JUYU-fsw/IT-preparation/PCB接线与引脚速查.md

# MSPM0G3507 终版小车 PCB 接线与引脚速查

> 用途：供人和 AI 快速查询板载接口、MCU 引脚及电气限制。后续开发优先查本文件，不从 Gerber 猜网络。  
> 原理图版本：`2026-06-13`，板名“2026电赛天猛星最终版”，V1.0。  
> 最后核对：2026-07-24。

## 1. 信息来源与使用规则

- **网络连接唯一依据**：`D:\ai embody\TI preparation\PCB\TI板卡\原理图文件\SCH_Schematic1_2026-06-13.pdf`
- **PCB 成品资料**：`D:\ai embody\TI preparation\PCB\TI板卡\Gerber2\10.zip`
- **工程引脚限制**：各工程下的 `project\尽量不要使用的引脚.txt`
- **实机修正优先级**：实机测量/已验证结果 > 2026-06-13 原理图 > 本文 > Gerber 丝印推断。
- 插头方向必须以 PCB 方形焊盘、数字 `1` 或连接器缺口确认；不要仅凭“从左到右”判断。
- 若本文与实物不一致，先停止上电并记录接口名、丝印、线序和测量结果，再更新本文。

## 2. 电源与共地

| 网络 | 用途 | 关键说明 |
|---|---|---|
| `12V_POWER` | 外部 12 V 输入开关前网络 | 经 U21 开关后成为 `12V` |
| `12V` | TB6612 VM、电机电源、UART3/UART5 电机兼容口 | 禁止接普通 5 V 串口模块 |
| `+5V` | TB6612 逻辑、编码器、OLED/IMU/部分接口供电 | USB-TTL 5 V 不得与已供电载板并联 |
| `VCC/3V3` | MSPM0 逻辑电源 | MCU GPIO 是否 5 V 容忍必须按器件资料确认 |
| `GND` | 全板公共地 | 外部电源、烧录器、USB-TTL 通信时必须共地 |

### 电源接口

| 接口 | 引脚/网络 | 用途 |
|---|---|---|
| U43（XT60） | 1=`12V_POWER`，2=`GND` | 主电源输入 |
| U21 | `12V_POWER` → 开关 → `12V` | 主电源开关 |
| U19 | IN+=`12V`，IN-=`GND`，OUT+=`+5V`，OUT-=`GND` | 12 V 转 5 V 模块 |
| CN14 | 1=`12V`，2=`GND` | 12 V 引出 |
| CN13 | 1=`+5V`，2=`GND` | 5 V 引出 |

### 上电安全

- 3S/12 V/5 V 链路和实车电机运行已验证，正式工程使用 `TB6612_OUTPUT_ENABLE=1`；上电默认 PWM=0，蓝牙 `1` 完成 3 秒等待后才运行。
- 外部电源给 PCB 和电机供电时，烧录器只接 GND、SWDIO、SWCLK、NRST、VTref；关闭或断开烧录器 target power。
- USB-TTL 单向日志只需 `GND` 和“板端 TX → USB-TTL RX”，不要接 USB-TTL 的 5 V。
- 电机额定电流 1 A、堵转电流 2 A；当前已启用 TB6612 并完成实车巡线，后续高负载运行仍需观察电流和散热余量。

## 3. 当前正式功能引脚总表

| 模块/信号 | MCU 引脚 | 外设/功能 | 当前状态 |
|---|---|---|---|
| 调试 UART TX | PB6 | UART1 TX | 已验证，115200 |
| 调试 UART RX | PB7 | UART1 RX | 已验证，通常不接 TTL TX |
| 蜂鸣器 | PA7 | GPIO | 低电平触发 |
| OLED SCL | PA31 | 软件 I2C | 已验证 |
| OLED SDA | PA28 | 软件 I2C | 已验证 |
| IMU SCL | PA1 | 软件 I2C | 线路曾验证；旧模块已损坏，待新模块复测 |
| IMU SDA | PA0 | 软件 I2C | 线路曾验证；旧模块已损坏，待新模块复测 |
| IMU INT | PB4 | GPIO/中断 | 原理图已接，当前非必需 |
| 状态 LED | PB16 | GPIO | 当前程序心跳 |
| 核心板 LED | PA14 | GPIO | 与 MOTOR1 编码器 B 共用，不作为正式心跳 |
| 电机 PWM A | PA12 | TIMG0_C0 | TB6612 PWMA |
| 电机方向 AIN1 | PB17 | GPIO | MOTOR2 驱动方向 |
| 电机方向 AIN2 | PB19 | GPIO | MOTOR2 驱动方向 |
| 电机 PWM B | PA13 | TIMG0_C1 | TB6612 PWMB |
| 电机方向 BIN1 | PA16 | GPIO | MOTOR1 驱动方向 |
| 电机方向 BIN2 | PB24 | GPIO | MOTOR1 驱动方向 |
| MOTOR1 编码器 A | PA25 | GPIO 双边沿中断 | 已纠正并验证 |
| MOTOR1 编码器 B | PA14 | GPIO 双边沿中断 | 已纠正并验证 |
| MOTOR2 编码器 A | PA26 | GPIO 双边沿中断 | 已验证 |
| MOTOR2 编码器 B | PA27 | GPIO 双边沿中断 | 已验证 |
| 灰度地址 A0 | PB25 | GPIO 输出 | 已验证 |
| 灰度地址 A1 | PB18 | GPIO 输出 | 已验证 |
| 灰度地址 A2 | PB21 | GPIO 输出 | 已验证 |
| 灰度 OUT | PB22 | GPIO 输入 | 必须接入；2026-07-27 曾漏接并导致持续 M00，补接后巡线正常 |

## 4. 串口接口

### 普通 5 V 四针串口

| 板载接口 | 1 脚 | 2 脚 | 3 脚 | 4 脚 | MCU 外设 |
|---|---|---|---|---|---|
| UART0 | +5V | GND | RX=PA1 | TX=PA0 | UART0 |
| UART1 | +5V | GND | RX=PB7 | TX=PB6 | UART1 |
| UART2 | +5V | GND | RX=PA24 | TX=PA23 | UART2 |

- 当前正式调试口使用 **UART1**，因为 PA0/PA1 已用于 IMU。
- UART0/1/2 的发送功能均已实机验证；USB-TTL 使用交叉接法：板 TX 接 TTL RX。

### 电机兼容/特殊串口

| 板载接口 | 1 脚 | 2 脚 | 3 脚 | 4 脚 | 说明 |
|---|---|---|---|---|---|
| UART3 | TX=PA23 | RX=PA24 | GND | 12V | 与 UART2 共用信号，含 12 V |
| UART4（Zigbee） | +5V | RX=PB3 | TX=PB2 | GND | 实际对应 MCU UART3 |
| UART5 | TX=PB6 | RX=PB7 | GND | 12V | 与 UART1 共用信号，含 12 V |

> **高风险**：UART3/UART5 的 4 脚是 12 V，不是 5 V。普通 USB-TTL 不得插到这两个接口的电源脚。

## 5. TB6612 与双电机接口

### TB6612 模块排针

| TB6612 信号 | PCB 网络/MCU | 说明 |
|---|---|---|
| VM | 12V | 电机功率电源 |
| VCC | +5V | 逻辑电源 |
| GND | GND | 两侧均有地 |
| PWMA | PA12 / TIMG0_C0 | MOTOR2 PWM |
| AIN1 | PB17 | MOTOR2 方向 |
| AIN2 | PB19 | MOTOR2 方向 |
| AO1/AO2 | MOTOR2 M4/M3 | MOTOR2 电机两端 |
| STBY | +5V | 硬件常使能 |
| PWMB | PA13 / TIMG0_C1 | MOTOR1 PWM |
| BIN1 | PA16 | MOTOR1 方向 |
| BIN2 | PB24 | MOTOR1 方向 |
| BO1/BO2 | MOTOR1 M1/M2 | MOTOR1 电机两端 |

### 六针电机接口线序

以下为原理图符号**自上而下**的网络顺序；实际插线前仍须以 PCB 的 1 脚标识确认物理方向。

| 接口 | 自上而下网络顺序 | 编码器引脚 |
|---|---|---|
| MOTOR1 | `M2/BO2`、`+5V`、`A/PA25`、`B/PA14`、`GND`、`M1/BO1` | A=PA25，B=PA14 |
| MOTOR2 | `M4/AO1`、`+5V`、`A/PA26`、`B/PA27`、`GND`、`M3/AO2` | A=PA26，B=PA27 |

### 电机与编码器参数

- 减速比：56:1；额定转速：178 RPM。
- 额定电流：1 A；堵转电流：2 A。
- 额定转矩：6.5 N·m；最大转矩：9 N·m。
- 编码器推荐 5 V 供电，本体为 AB 两相；每电机轴 11 个 AB 周期。
- MCU 软件四倍频后理论输出轴计数：`11×56×4=2464 count/rev`。
- 两轴十圈实测平均：`2473.5 count/rev`；正式速度闭环按用户决定采用商家 `2450 count/rev`。
- 5 V 编码器的 AB 输出电平兼容性尚需确认：检查是否有板载调理、开漏上拉或 3.3 V 兼容输出。

## 6. 蜂鸣器、OLED 与 IMU

### 蜂鸣器 U3

| 引脚 | 网络 | 说明 |
|---|---|---|
| 1 | VCC/3.3V | 模块逻辑侧供电 |
| 2 | PA7 | 低电平触发 |
| 3 | GND | 地 |

### OLED

| 顺序 | 网络 | 说明 |
|---|---|---|
| 1 | GND | 地 |
| 2 | VCC | 电源 |
| 3 | SCL=PA31 | 软件 I2C |
| 4 | SDA=PA28 | 软件 I2C |

- 已验证为 SSD1306、128×64、I2C 地址 0x3C。

### IMU（U41，板上标注 MPU6050）

| 引脚 | 网络 | 当前用途 |
|---|---|---|
| 1 VCC | +5V | 模块供电 |
| 2 GND | GND | 地 |
| 3 SCL | PA1 | 软件 I2C SCL |
| 4 SDA | PA0 | 软件 I2C SDA |
| 5 XDA | NC | 未使用 |
| 6 XCL | NC | 未使用 |
| 7 AD0 | GND | I2C 地址选择为 0x68 |
| 8 INT | PB4 | 中断输出，当前非必需 |

- 实装芯片识别为 MPU-6500 或兼容器件：I2C 地址 0x68，`WHO_AM_I=0x70`。
- 上电水平静止约 4 秒，以 125 Hz 采集 500 点完成零偏校准。
- 上述识别与校准是旧模块损坏前的历史结果；该模块现已移除。替换 GY-521 后需重新验证 `WHO_AM_I`、温升、零偏和安装方向。

## 7. 舵机接口

四个 XH-3A 接口均为三针：1=信号、2=+5V、3=GND。

| 接口 | 1 脚信号 | 定时器通道 |
|---|---|---|
| U35 | PA22 | TIMA0_C1 |
| U39 | PA15 | TIMA0_C2 |
| U36 | PA17 | TIMA0_C3 |
| U34 | PA21 | TIMA0_C0 |

> PA21、PA23 属于核心板建议避免使用的特殊引脚；使用 PA21 舵机口前应核对核心板器件限制。

## 8. RGB 与扩展接口

### RGB 三针接口

| 接口 | 信号 | 电源 | 地 |
|---|---|---|---|
| U1 | PA14 | VCC | GND |
| U2 | PA18 | VCC | GND |
| U5 | PA2 | VCC | GND |

- PA14 同时连接核心板 LED，并在当前工程中作为 MOTOR1 编码器 B，不应再接 RGB 负载。

### 其余 IO

- H55：1=PB25，2=PB18，3=PB21，4=PB22，5=PA30，6=PB0，7=PB1，8=PB10，9=PB11，10=PB14。
- H56：10=PB5，9=PB15，8=PA10，7=PB16，6=PB13，5=PA11，4=PB12，3=PB26，2=PB27；1 脚在原理图中未标出有效网络，使用前须实测确认。
- H51/H52/H53/H54/H60/H61 为辅助排针/引出位；原理图未给出统一功能名，未确认前不要按位置猜用途。

## 9. 核心板 80 Pin 对照

| Pin | 网络 | Pin | 网络 | Pin | 网络 | Pin | 网络 |
|---:|---|---:|---|---:|---|---:|---|
| 1 | GND | 2 | GND | 41 | GND | 42 | +5V |
| 3 | PA0 | 4 | PA28 | 43 | GND | 44 | 3V3 |
| 5 | PA1 | 6 | PA31 | 45 | RST | 46 | PA18 |
| 7 | PA8 | 8 | PB4 | 47 | PB11 | 48 | PB14 |
| 9 | PA9 | 10 | PB5 | 49 | PB10 | 50 | PA7 |
| 11 | PB15 | 12 | PA10 | 51 | PB0 | 52 | PB1 |
| 13 | PB16 | 14 | PA11 | 53 | PA30 | 54 | GND |
| 15 | PB2 | 16 | PB12 | 55 | PB21 | 56 | PB22 |
| 17 | PB3 | 18 | PB13 | 57 | GND | 58 | +5V |
| 19 | DIO | 20 | CLK | 59 | GND | 60 | 3V3 |
| 21 | GND | 22 | 3V3 | 61 | PA2 | 62 | PA23 |
| 23 | GND | 24 | +5V | 63 | PB19 | 64 | PA21 |
| 25 | PB6 | 26 | PB7 | 65 | PB17 | 66 | PB18 |
| 27 | PB8 | 28 | PB9 | 67 | PA16 | 68 | PA17 |
| 29 | PA12 | 30 | PA13 | 69 | PA14 | 70 | PA15 |
| 31 | PB23 | 32 | PB26 | 71 | PB20 | 72 | PA22 |
| 33 | PB27 | 34 | PA29 | 73 | PB25 | 74 | PB24 |
| 35 | AGND | 36 | CHIP | 75 | PA25 | 76 | PA24 |
| 37 | GND | 38 | 3V3 | 77 | PA27 | 78 | PA26 |
| 39 | GND | 40 | +5V | 79 | GND | 80 | GND |

## 10. 核心板建议避免使用的引脚

- 建议避免：PA23、PA21、PA19、PA20、PA5、PA6、PA4、PA3。
- PA14 连接核心板 LED；当前又作为 MOTOR1 编码器 B，禁止再分配其他功能。
- 若必须使用 PA23/PA21，核心板说明要求移除 R8、R9、C14、C15 后才可正常使用；实际操作前必须再次核对核心板原理图。
- 载板虽然已将 PA23 引到 UART2/UART3、PA21 引到舵机 U34，但“已布线”不等于“可无条件使用”。

## 11. 已确认的易错点

- 旧记录曾把 MOTOR1 编码器写成 PA24/PA25；**正确值是 PA25/PA14**。
- 板载 `UART4` 是接口编号，实际对应 MCU UART3（PB2/PB3）。
- UART3 与 UART2 共用 PA23/PA24，但 UART3 接口带 12 V。
- UART5 与 UART1 共用 PB6/PB7，但 UART5 接口带 12 V。
- UART0 PA0/PA1 当前已被 IMU 软件 I2C 使用，正式调试串口必须用 UART1。
- 旧 IMU 已出现 `WHO_AM_I=FF`、三轴全零并明显发烫，当前已移除且禁止再次上电；LED 亮不代表芯片正常。
- 替换件选标准 GY-521 MPU6050，必须逐针确认顺序为 `VCC/GND/SCL/SDA/XDA/XCL/AD0/INT`，并确认排母插入方向使 VCC 对 VCC。相同针序反向插入仍会烧毁。
- 新模块首次只接控制板，先核对实际供电、电流、温升和 I2C 响应；确认正常后再接电机。新 GY-521 通常为 `WHO_AM_I=0x68`，软件需兼容旧模块的 0x70 和新模块的 0x68。
- MOTOR1/MOTOR2 与整车左右轮、正 PWM 与前进方向的关系仍须装车实测，不能仅凭接口编号推断。

## 12. AI 修改代码前检查清单

1. 先查“当前正式功能引脚总表”，确认没有重复占用。
2. 涉及电源时明确写出 3.3 V、5 V 或 12 V，不使用含糊的 `VCC` 代替。
3. 涉及 UART3/UART5 时先提示其接口含 12 V。
4. 涉及电机时确认主电源、左右轮映射、PWM 方向、编码器符号及 `TB6612_OUTPUT_ENABLE=1`。
5. 涉及编码器时固定使用 MOTOR1=PA25/PA14、MOTOR2=PA26/PA27。
6. 涉及 IMU 时保留 PA0/PA1，不把调试 UART 改回 UART0。
7. 新发现的实机线序或原理图差异必须同时更新本文件和《调试日志.md》。
