JUYU-fsw/IT-preparation/开发进度.md

# MSPM0G3507 终版小车开发进度

> 更新日期：2026-07-26
> 本文件只记录当前有效状态、已完成里程碑和真正未完成事项；历史排错过程见《调试日志.md》。

## 项目位置

- 工作区：`D:\ai embody\TI preparation`
- 正式工程：`D:\ai embody\TI preparation\project\MSPM0G3507_Car`
- Keil 工程：`project\MSPM0G3507_Car\project\mdk\SeekFree_MSPM0G3507_Device_Library.uvprojx`
- 主程序：`project\MSPM0G3507_Car\project\user\src\main.c`
- `before the final car` 仅为学长车 PID 历史测试副本，不是当前开发基线。

## 当前项目状态

此小车准备用于参加电赛，因此在分析时可结合往年考题。终版双轮小车的实车固件已经完成主控工具链、烧录、板载外设、双电机驱动、双编码器、速度闭环、HC-05 双向通信、YB-MVX05 八路灰度接入以及自适应巡线。用户已完成实车验证并确认巡线效果完美。

## 项目开发路径

**烧录与 LED ✅ → UART 调试 ✅ → 蜂鸣器 ✅ → OLED ✅ → IMU 识别与校准 ✅ → TB6612 与供电 ✅ → 双编码器解码与标定 ✅ → 自有电机速度闭环 ✅ → HC-05 双向启停 ✅ → 八路灰度接入 ✅ → 自适应巡线 ✅ → 弯道/急弯/丢线处理 ✅ → 按赛题扩展与逐步提速 ← 当前**

- 实车不是“等待接入灰度”或“等待基础循迹”阶段；这两项已经完成。
- 当前主线是保持已验收巡线基线，按赛题增加功能；若需要提速，每次只把直线速度提高 5 RPM 并复测全赛道。

## 当前硬件映射

| 功能 | 当前有效映射 |
|---|---|
| 左轮 | MOTOR1 编码器 PA25/PA14 + TB6612 B |
| 右轮 | MOTOR2 编码器 PA26/PA27 + TB6612 A |
| 电机 PWM/方向 | A：PA12/PB19/PB17；B：PA13/PA16/PB24 |
| 调试串口 | UART1，PB6/PB7，115200 |
| HC-05 | 板载 UART4（MCU UART3），PB2/PB3，9600 |
| OLED | SSD1306，PA31/PA28 软件 I2C，地址 0x3C |
| 蜂鸣器 | PA7，低电平触发 |
| 灰度地址 A0/A1/A2 | PB25/PB18/PB21 |
| 灰度数字输出 OUT | PB22 |

灰度模块使用 H55-1～H55-4，黑线有效为高电平；软件约定 bit0 为最左侧、bit7 为最右侧。传感器阵列位于驱动轮轴线前约 7～8 cm，该安装距离已通过实车验证。

## 已验收实车固件参数

| 类别 | 当前参数 |
|---|---|
| 电机 | 56:1，178 RPM，额定电流 1 A、堵转电流 2 A |
| 编码器换算 | `2450 count/rev` |
| 基础循环 | 10 ms |
| 测速/速度 PI 周期 | 20 ms |
| 双轮速度 PI | KP=10、KI=1.0、KD=0 |
| 速度滤波 | `alpha=0.25` |
| 输出限幅 | 8000 |
| 起步补偿 | 1000 |
| 直线巡线速度 | 55 RPM |
| 普通弯最低速度 | 20 RPM |
| 急弯 | 外轮 28 RPM、内轮 -12 RPM |
| 丢线搜索 | 外轮 22 RPM、内轮 -10 RPM，最多 200 ms |

## 已验收实车巡线行为

1. 上电保持停车；HC-05 发送 `1` 后等待 3 秒并持续巡线，发送 `0` 立即停车。
2. 八路灰度以 `-350～350` 权重计算位置误差。
3. 普通弯按误差和误差变化率立即降低基础速度；回正后逐渐恢复速度。
4. 外轮不会因转向修正而超过当前基础速度；内轮可减速、停止或反转。
5. 最外侧连续命中 20 ms 后进入急弯状态，中心通道稳定 30 ms 后退出。
6. 丢线后沿最后一次误差方向搜索 200 ms，仍未找到才停车。
7. 串口日志输出 `mode/mask/error/base/correction/target/rpm`。

## 已完成里程碑

- **2026-07-23**：Keil/Arm Compiler 6、CMSIS-DAP、LED、UART、蜂鸣器和 OLED 实机通过。
- **2026-07-23**：MPU-6500 兼容芯片识别与零偏校准完成。
- **2026-07-23**：TB6612 底层和双编码器四倍频解码完成；MOTOR1 引脚纠正为 PA25/PA14。
- **2026-07-23**：自有电机十圈标定平均约 2473.5 count/rev；正式闭环按用户决定采用商家 2450 count/rev。
- **2026-07-25**：左右轮、驱动通道和编码器反馈符号完成实车校正。
- **2026-07-25**：30 RPM 闭环误差约 1%；20/30/60/100 RPM 架空测试均稳定，最高 duty 不到 6000。
- **2026-07-25**：HC-05 PB2/PB3 双向通信及 `1/0` 启停实机通过。
- **2026-07-26**：YB-MVX05 接入终版载板，完成八路扫描、加权位置误差和巡线外环。
- **2026-07-26**：完成动态弯道降速、外轮限速、急弯状态机和丢线恢复；用户实车确认巡线完美。
- **2026-07-26**：巡线直线速度继续提高到 70 RPM，用户确认实车稳定；70 RPM 作为当前速度基线。
- **2026-07-26**：`Car_angle` 已加入 MPU6050/MPU6500 兼容角度累计、角度 PID 和编码器里程计；倾斜安装通过三轴陀螺仪向车体竖直轴投影修正。
- **2026-07-26**：安装状态下采用实测比例系数 1.268 后，手动旋转 90° 显示 89.7°，达到当前 ±3°测角目标；一圈手动测试显示 372.2°，后续需用可靠角度基准复标。
- **2026-07-26**：修复角度调试时 HC-05 乱码/不稳定：日志缓冲区由 128 扩至 256 字节，详细 IMU 遥测只发 UART1，蓝牙仅保留命令和短应答。
- **2026-07-26**：停车抗扰测试期间 IMU 后续返回 `WHO_AM_I=FF` 且三轴全零；模块拔下后明显发烫，判定硬件已失效并停止使用。固件已加入探测重试、故障提示和角度保持禁用保护。
- **2026-07-27**：已更换灰度传感器和 MPU6050。角度环代码开始合入主线，驱动已兼容 `WHO_AM_I=0x68/0x70`；旧模块的 1.268 比例系数已取消，新模块从 1.000 开始重新标定。新灰度板参数等待实物确认。
- **2026-07-27**：新灰度传感器巡线已恢复正常；此前 OLED 显示 `M00` 且小车不走的原因是灰度 `OUT` 信号线漏接。补接 `OUT→PB22` 后黑线检测与巡线实车正常。

## 当前待办与风险

以下只保留尚未完成或长期存在的事项：

- **P0｜验收新 MPU6050**：首次仅接控制板低风险上电，确认供电、温升和 `WHO_AM_I` 正常；随后重新完成静态零偏、倾斜投影、±90°和分段 360°标定，再测试停车抗扰回正和行驶航向保持。
- **P0｜修复 MPU 运动累计误差**：新 MPU 静止时长期保持 0、不发热，但多次角度保持后会累计到十余度；已定位到 `TIM_G12` 采用 `0xFFFF` 周期而角度代码按 32 位回绕计算的风险，尚未修改和复测。
- **P0｜修复 HC-05 单向乱码**：手机发送的命令能被小车正常执行，但 MCU 经 PB2 向 HC-05 返回的 ASCII 显示为 `�`；PB2/PB3 无软件引脚冲突，问题尚未解决。
- **P0｜自动直角转弯与精准定位**：需要实现灰度巡线路口触发、唯一可走方向判断、90°闭环转弯、转后重新捕线，以及编码器定距停车；当前尚未完成整车状态机验收。
- **P1｜巡线速度基线**：当前 70 RPM 已稳定；如需继续提速，只先调整 `LINE_FOLLOW_STRAIGHT_RPM`，每次增加 5 RPM 并复测直线、缓弯、急弯和丢线恢复。
- **P1｜核对 TB6612 电流与温升余量**：电机额定 1 A、堵转 2 A；长期高负载运行时继续观察驱动器、电机和导线温升，禁止人为堵转。
- **P2｜确认编码器 5 V 输出电平裕量**：当前实机工作正常，但仍建议核对 AB 输出是否经过板载调理或符合 MSPM0 GPIO 电平要求。
- **风险｜供电冲突**：载板已有主电源或核心板 USB 供电时，不连接 USB-TTL 的 5 V；烧录器和载板必须共地。
- **风险｜接口编号混淆**：板载 UART4 实际对应 MCU UART3（PB2/PB3）；带 12 V 的 UART3/UART5 不作为普通串口使用。

## 后续改动原则

- 已验收的巡线参数作为当前安全基线，不同时大幅修改速度、PD、急弯和丢线参数。
- 只提速时优先修改 `LINE_FOLLOW_STRAIGHT_RPM`。
- 修改灰度板安装方向或线序后，必须重新确认 bit0～bit7 的左右顺序。
- 修改速度 PI 周期后必须同步重新整定 KI 和滤波参数。
- 新的实车结论需同步更新本文件、总档案、接线速查和调试日志。
