JUYU-fsw/IT-preparation/tmp/cat_animation/contact.png

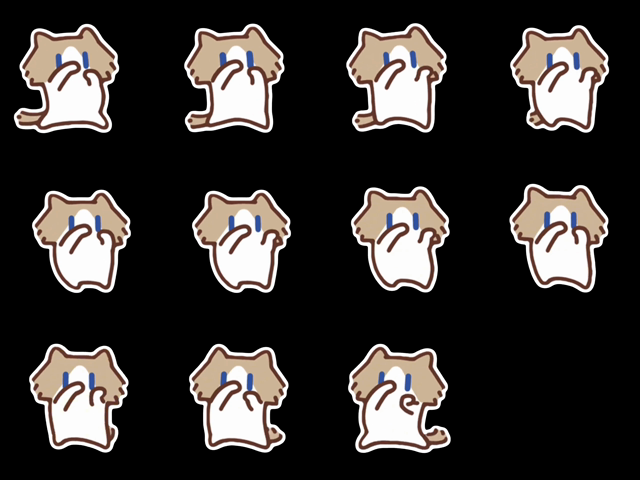
tmp/cat_animation/contact.png
