JUYU-fsw/IT-preparation/tmp/cat_animation/mono_contact.png

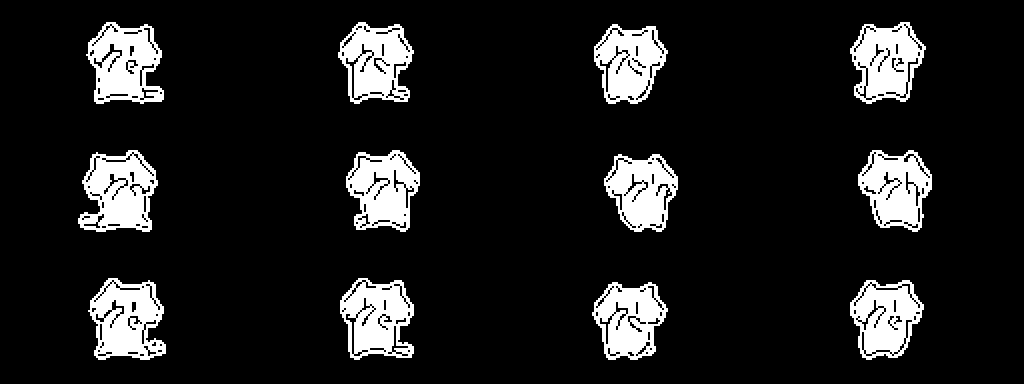
tmp/cat_animation/mono_contact.png
