JUYU-fsw/IT-preparation/tmp/pdfs/car_topics/01_contact.jpg

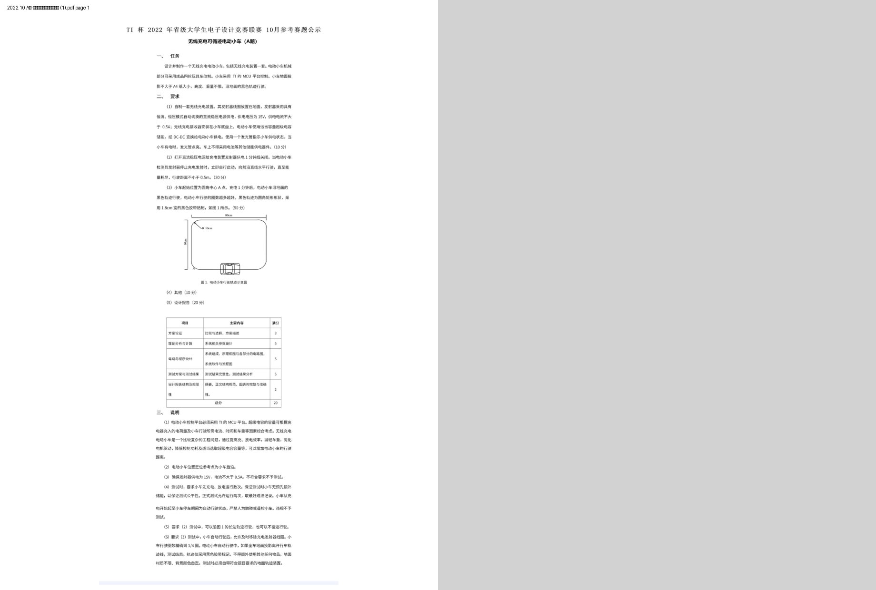
tmp/pdfs/car_topics/01_contact.jpg
