JUYU-fsw/IT-preparation/tmp/pdfs/car_topics/03_contact.jpg

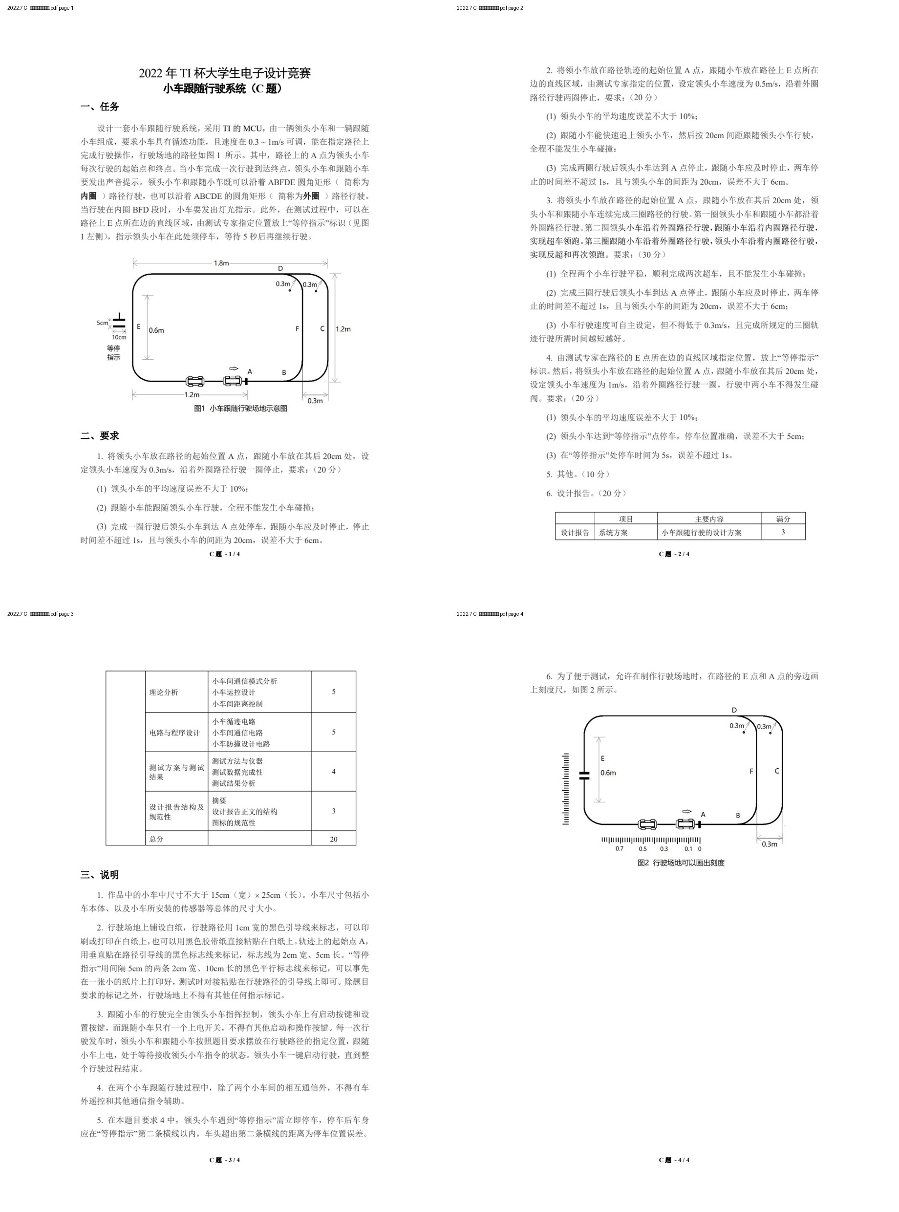
tmp/pdfs/car_topics/03_contact.jpg
