JUYU-fsw/IT-preparation/tmp/pdfs/car_topics/04_contact.jpg

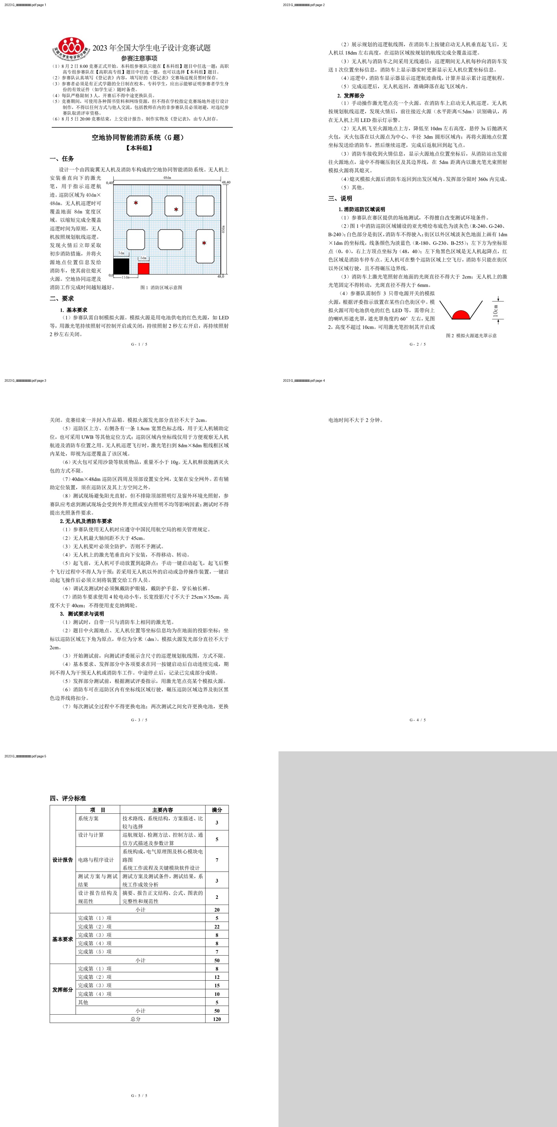
tmp/pdfs/car_topics/04_contact.jpg
