JUYU-fsw/IT-preparation/tmp/pdfs/car_topics/05_contact.jpg

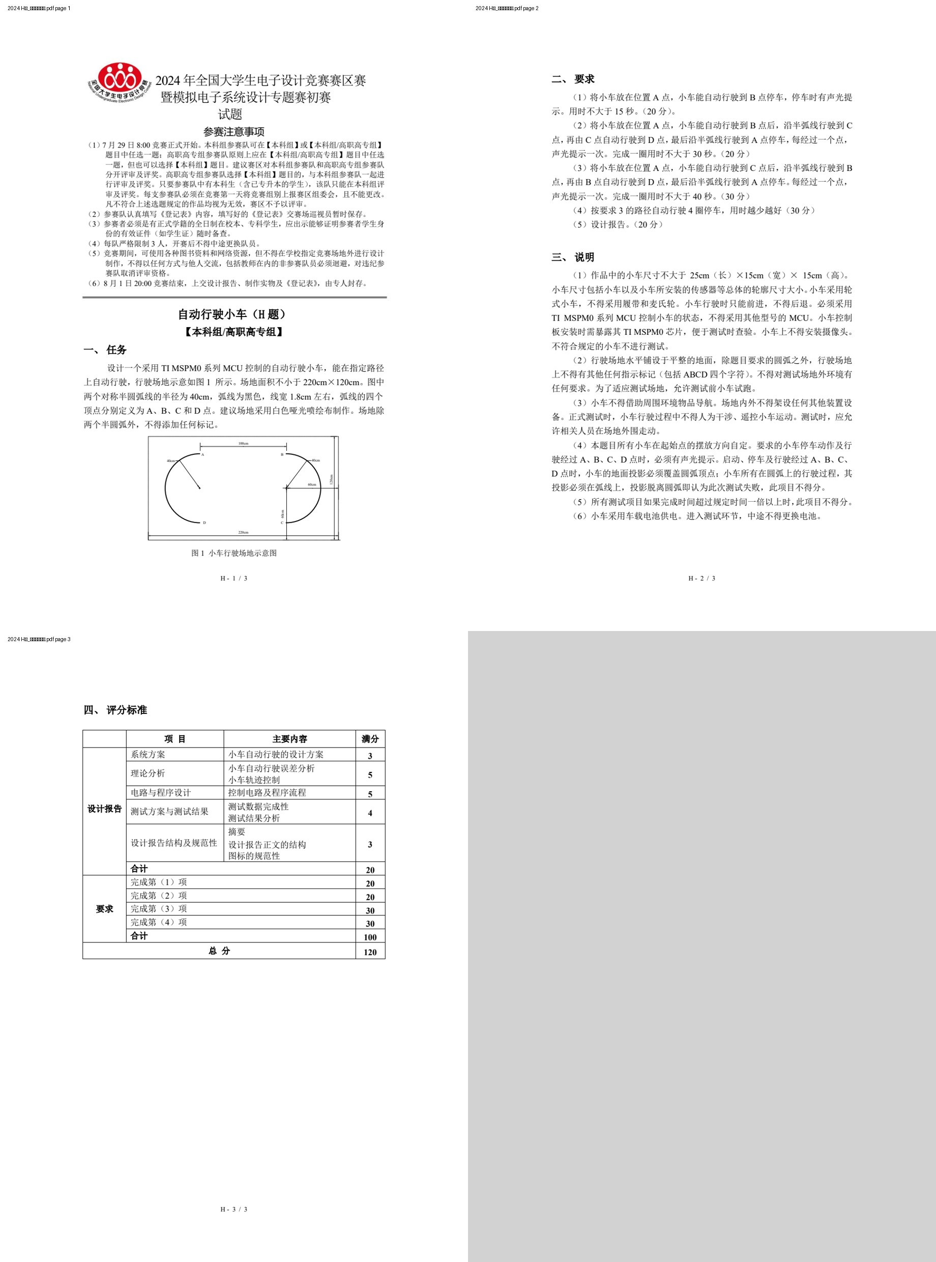
tmp/pdfs/car_topics/05_contact.jpg
