JUYU-fsw/IT-preparation/tmp/pdfs/car_topics/06_contact.jpg

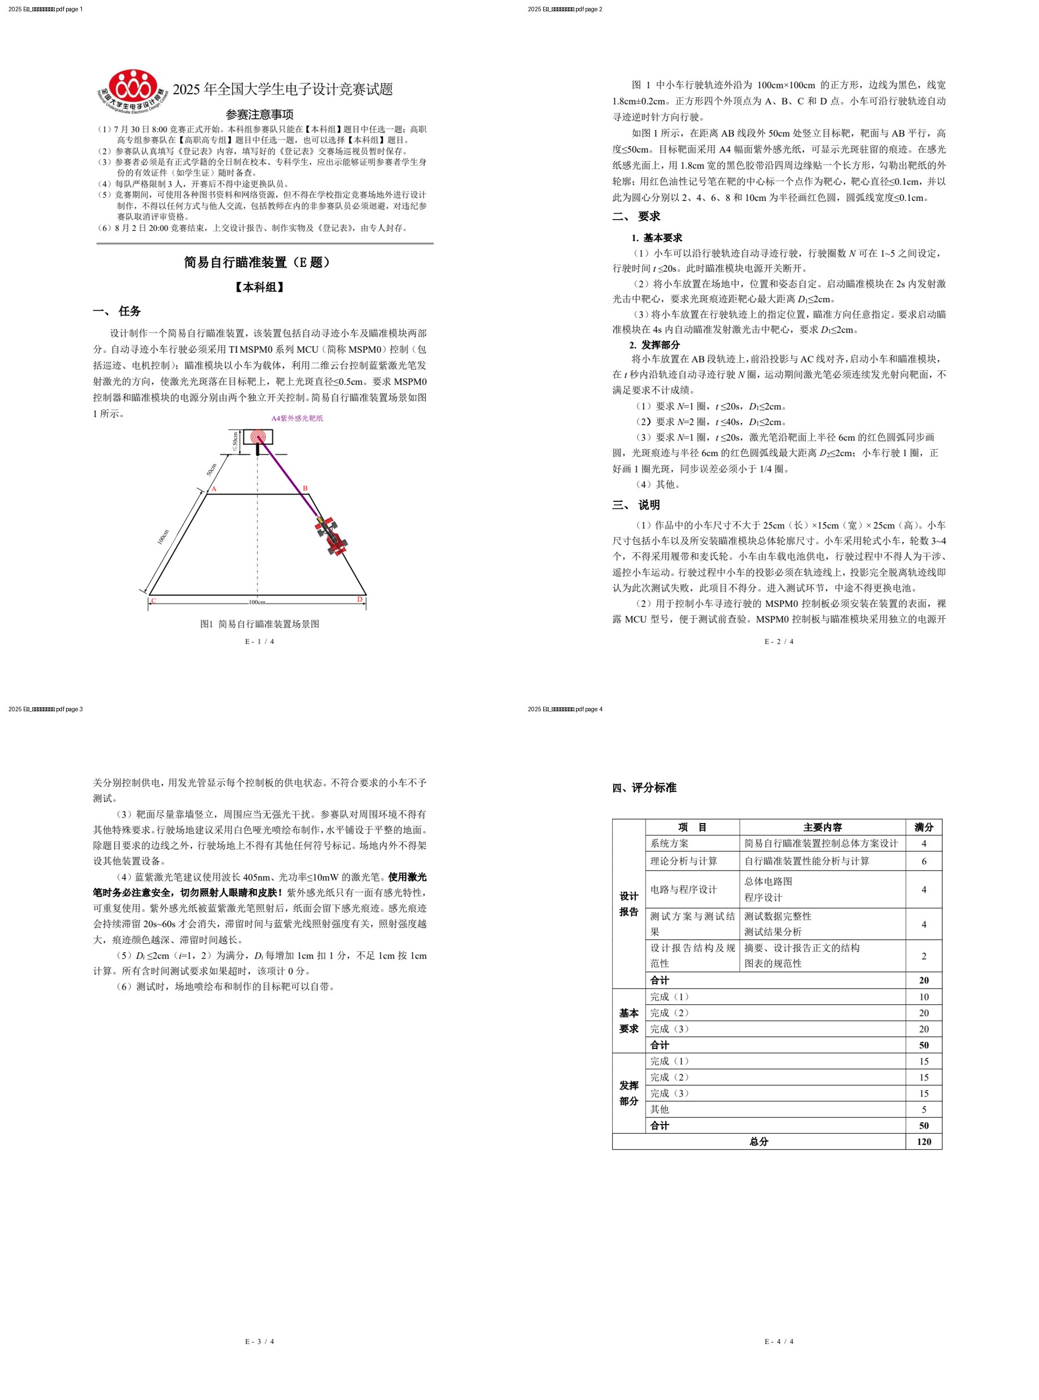
tmp/pdfs/car_topics/06_contact.jpg
