JUYU-fsw/IT-preparation/tmp/pdfs/car_topics/07_contact.jpg

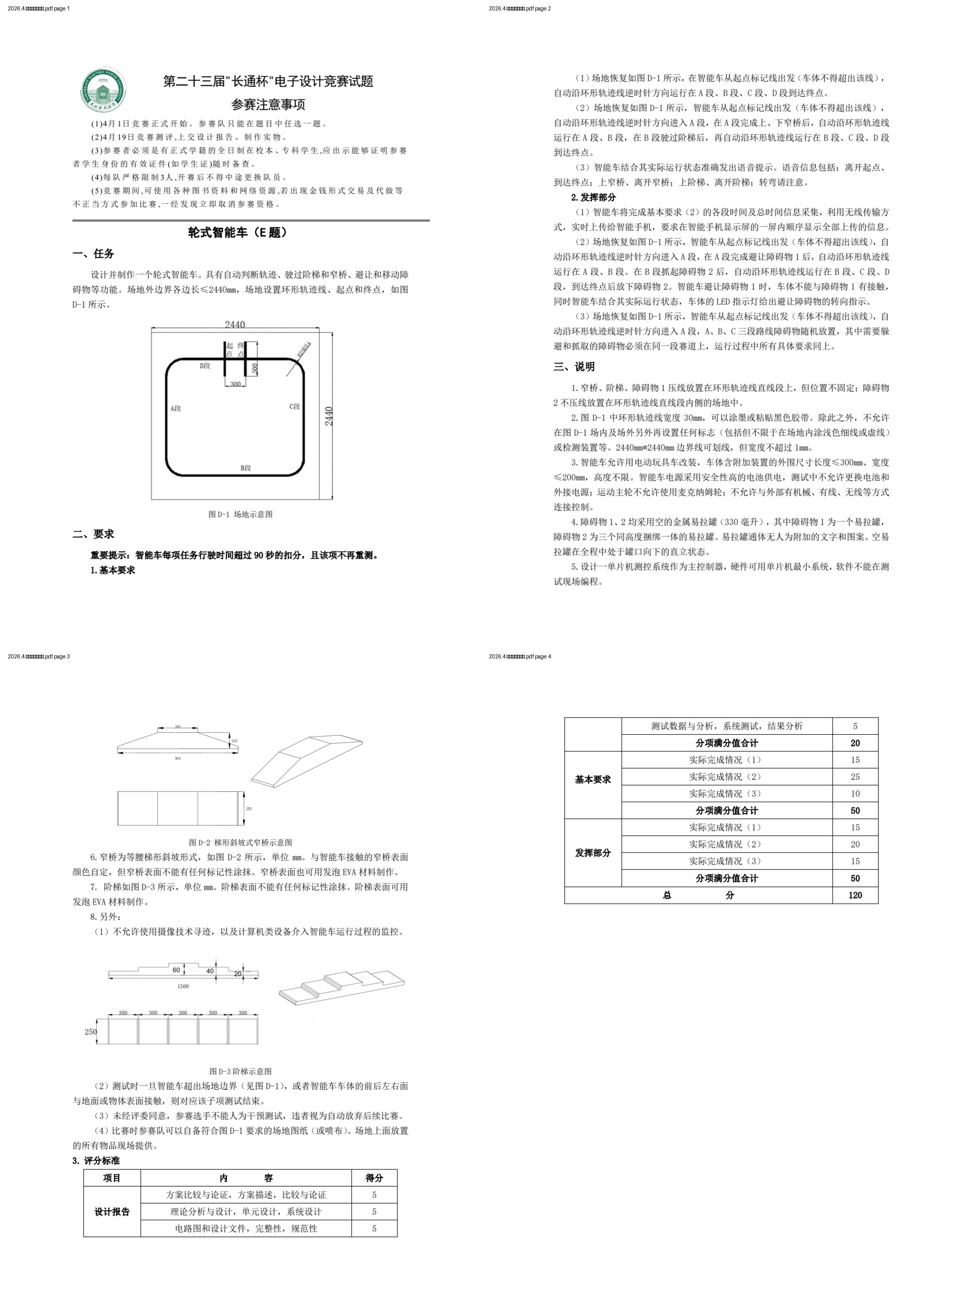
tmp/pdfs/car_topics/07_contact.jpg
