JUYU-fsw/IT-preparation/tmp/pdfs/contest_review/doc1-1.jpg

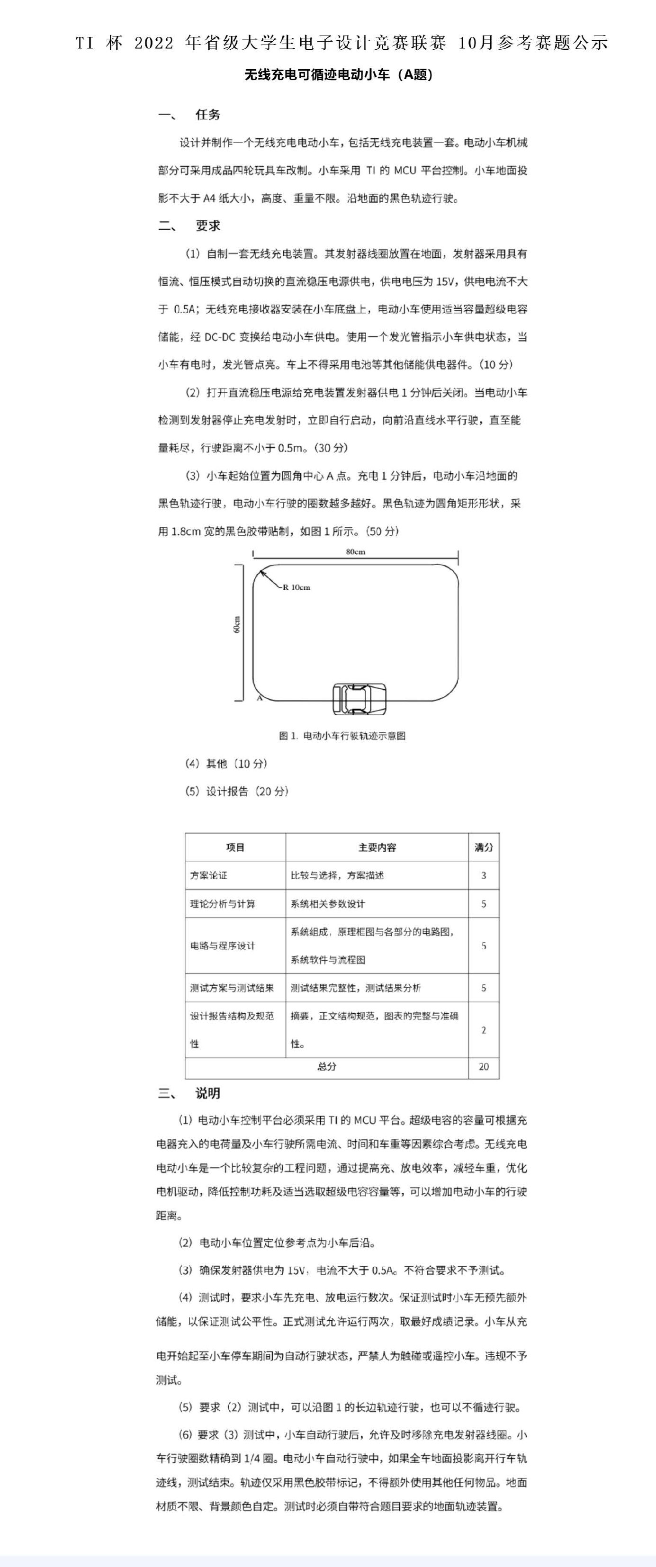
tmp/pdfs/contest_review/doc1-1.jpg
