JUYU-fsw/IT-preparation/tmp/pdfs/contest_review/doc2-1.jpg

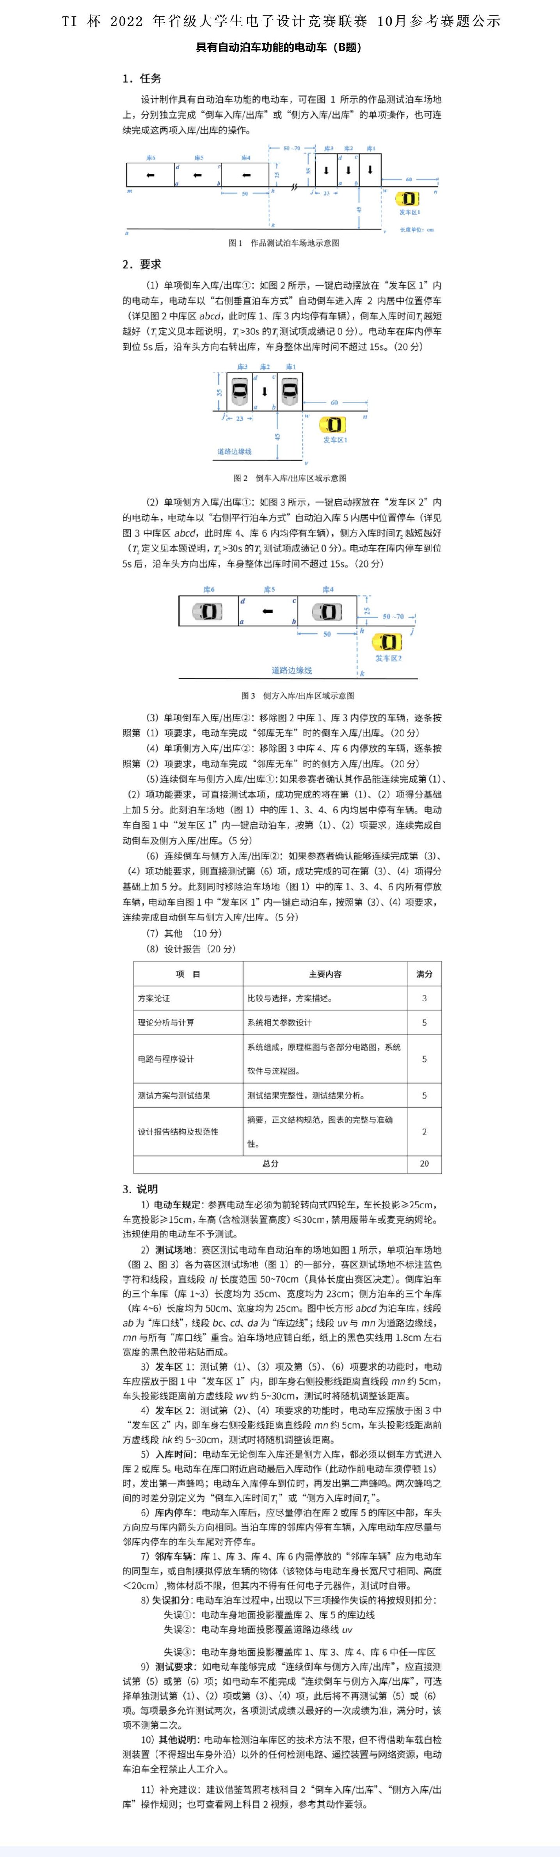
tmp/pdfs/contest_review/doc2-1.jpg
