JUYU-fsw/IT-preparation/tmp/pdfs/contest_review/doc3-1.jpg

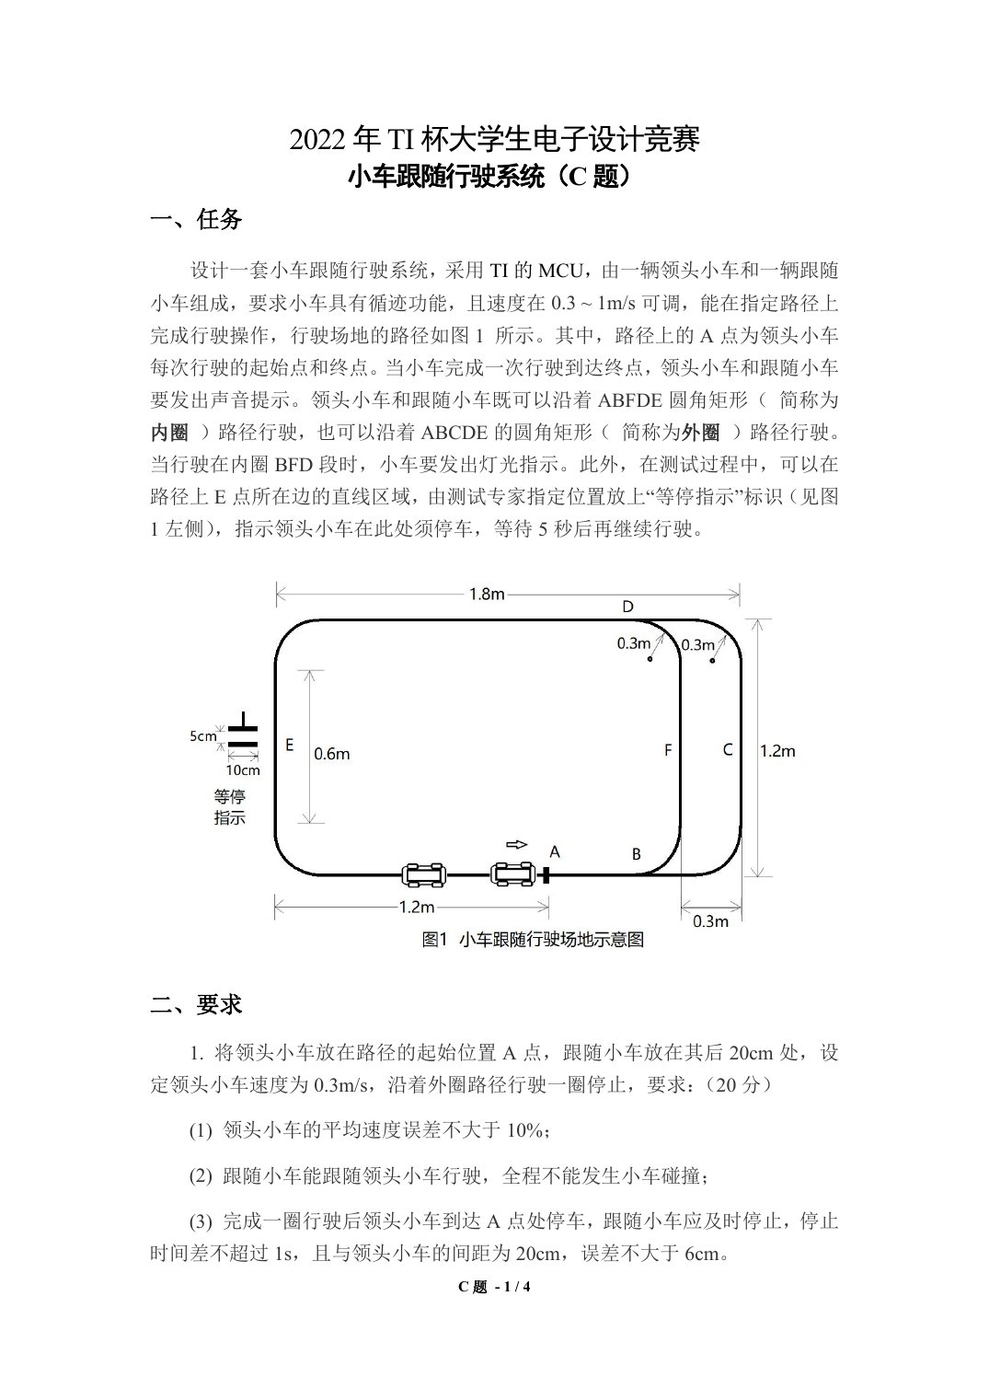
tmp/pdfs/contest_review/doc3-1.jpg
