JUYU-fsw/IT-preparation/tmp/pdfs/contest_review/doc3-2.jpg

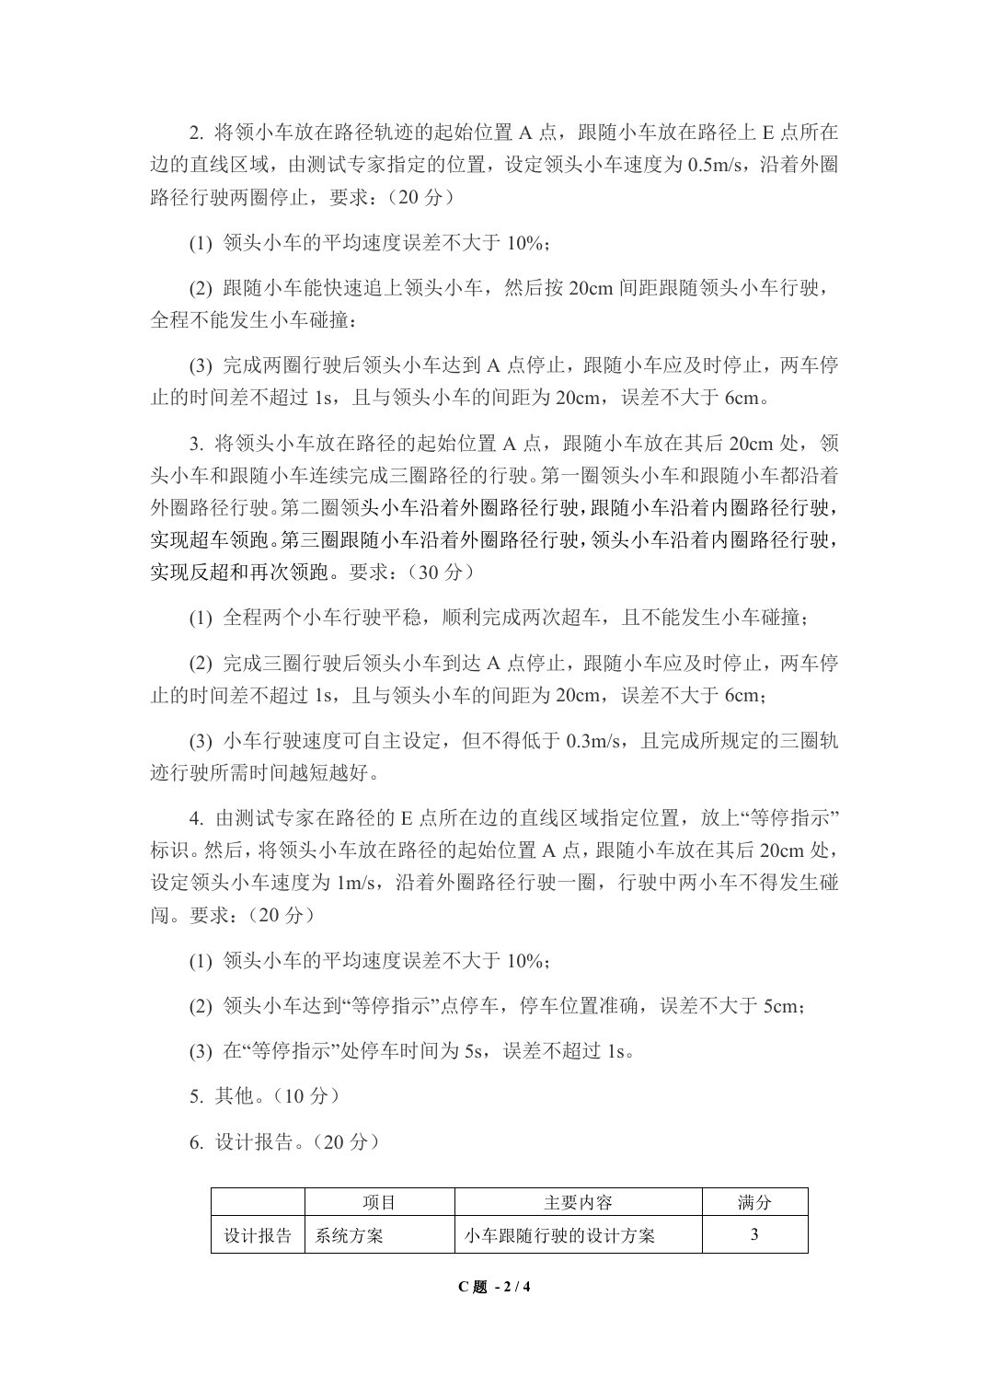
tmp/pdfs/contest_review/doc3-2.jpg
