JUYU-fsw/IT-preparation/tmp/pdfs/contest_review/doc3-3.jpg

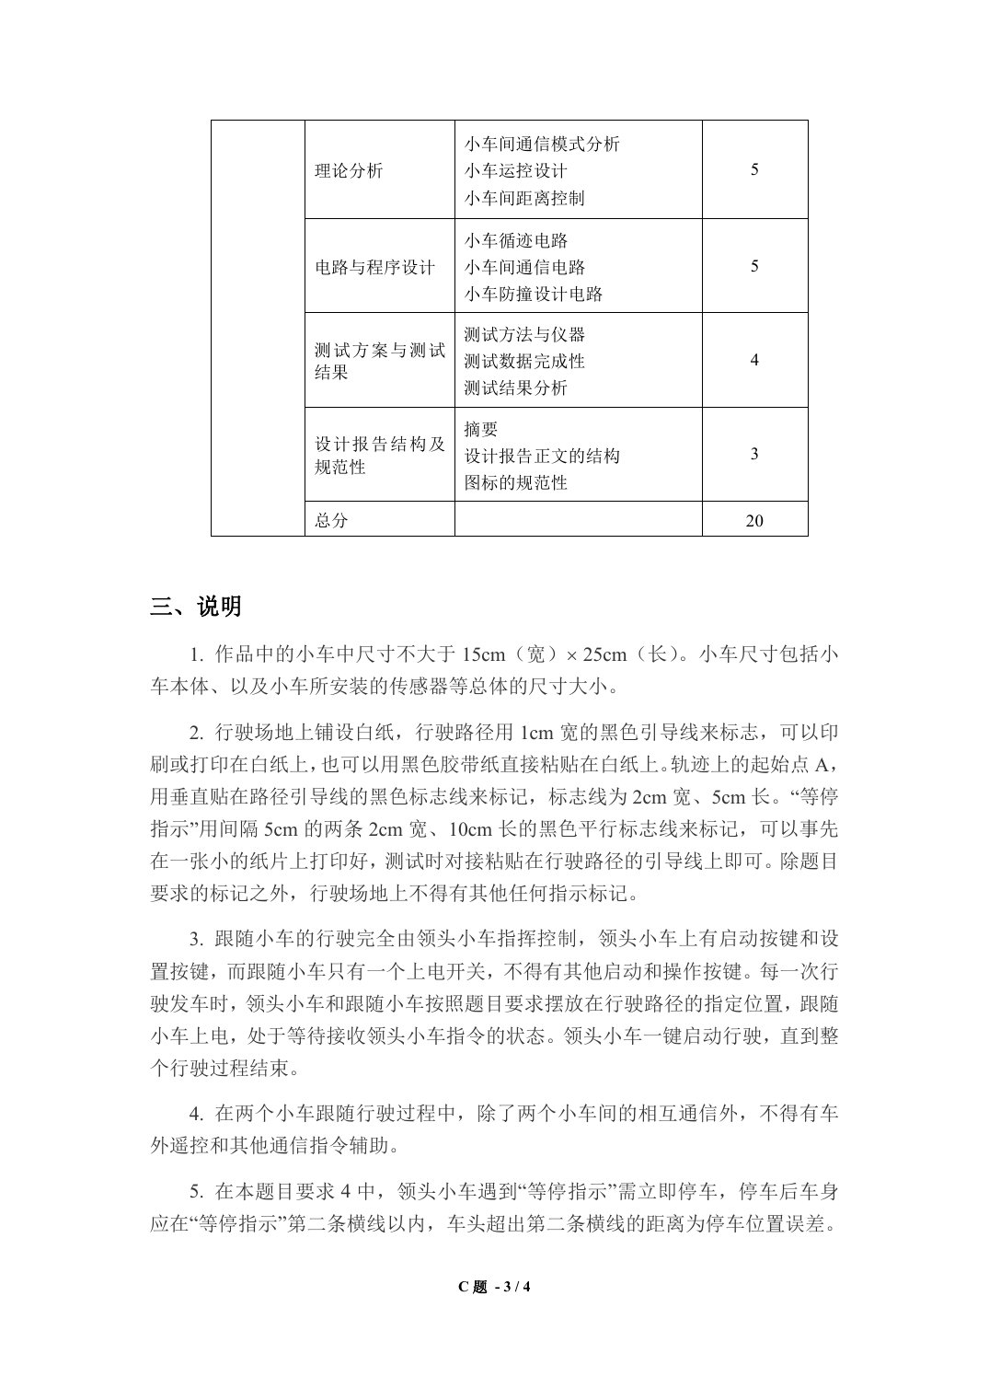
tmp/pdfs/contest_review/doc3-3.jpg
