JUYU-fsw/IT-preparation/tmp/pdfs/contest_review/doc3-4.jpg

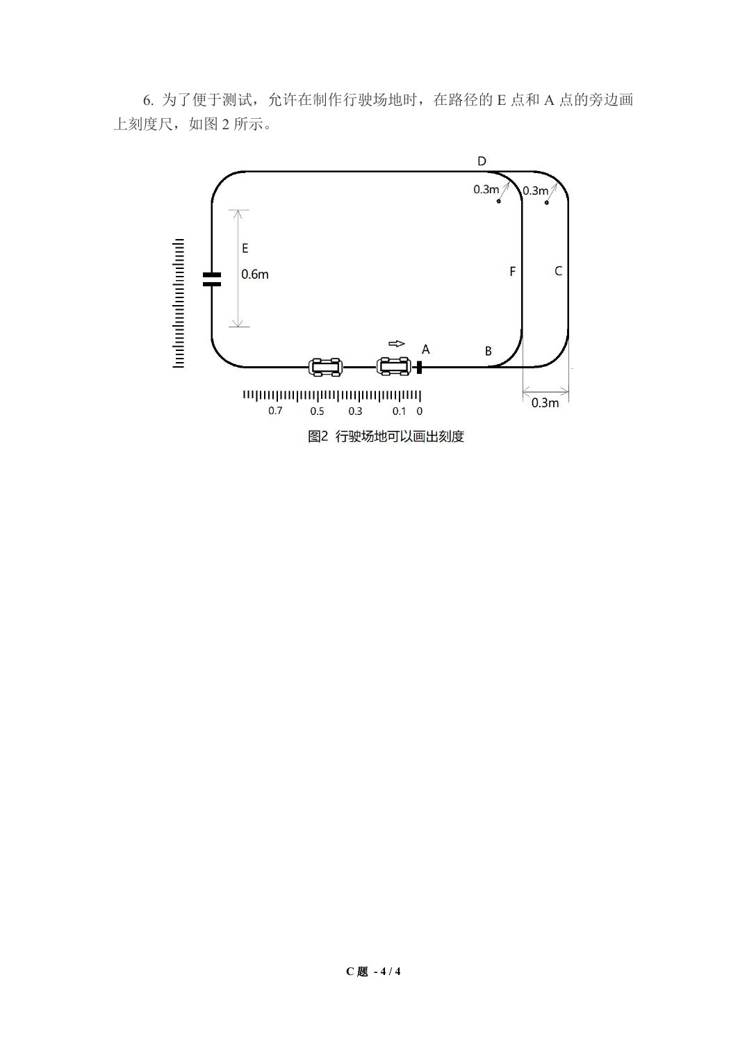
tmp/pdfs/contest_review/doc3-4.jpg
