JUYU-fsw/IT-preparation/tmp/pdfs/contest_review/doc4-1.jpg

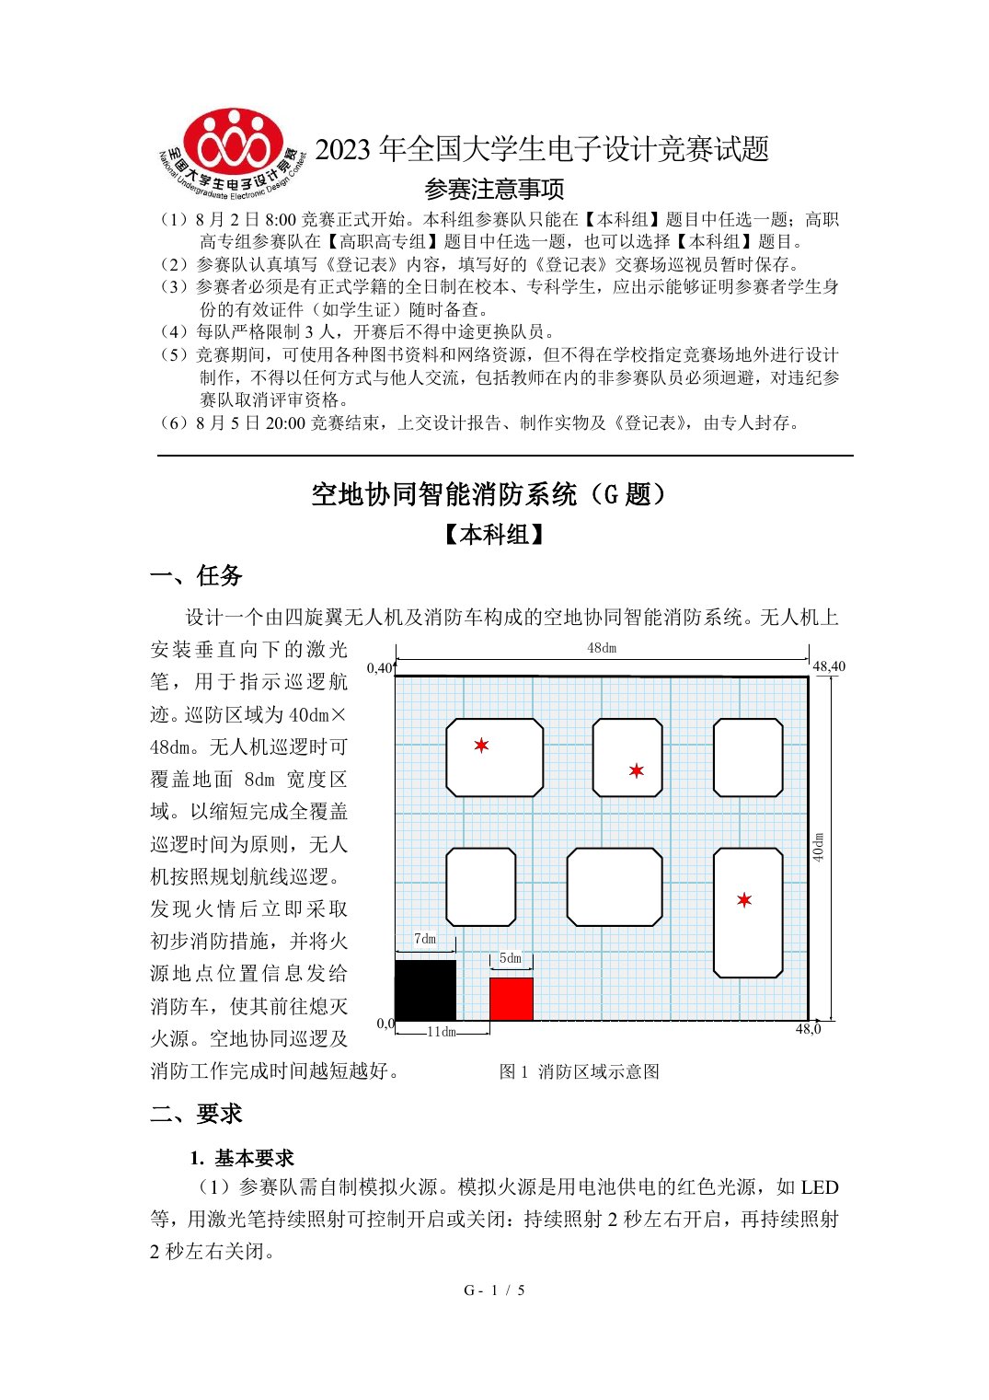
tmp/pdfs/contest_review/doc4-1.jpg
