JUYU-fsw/IT-preparation/tmp/pdfs/contest_review/doc4-2.jpg

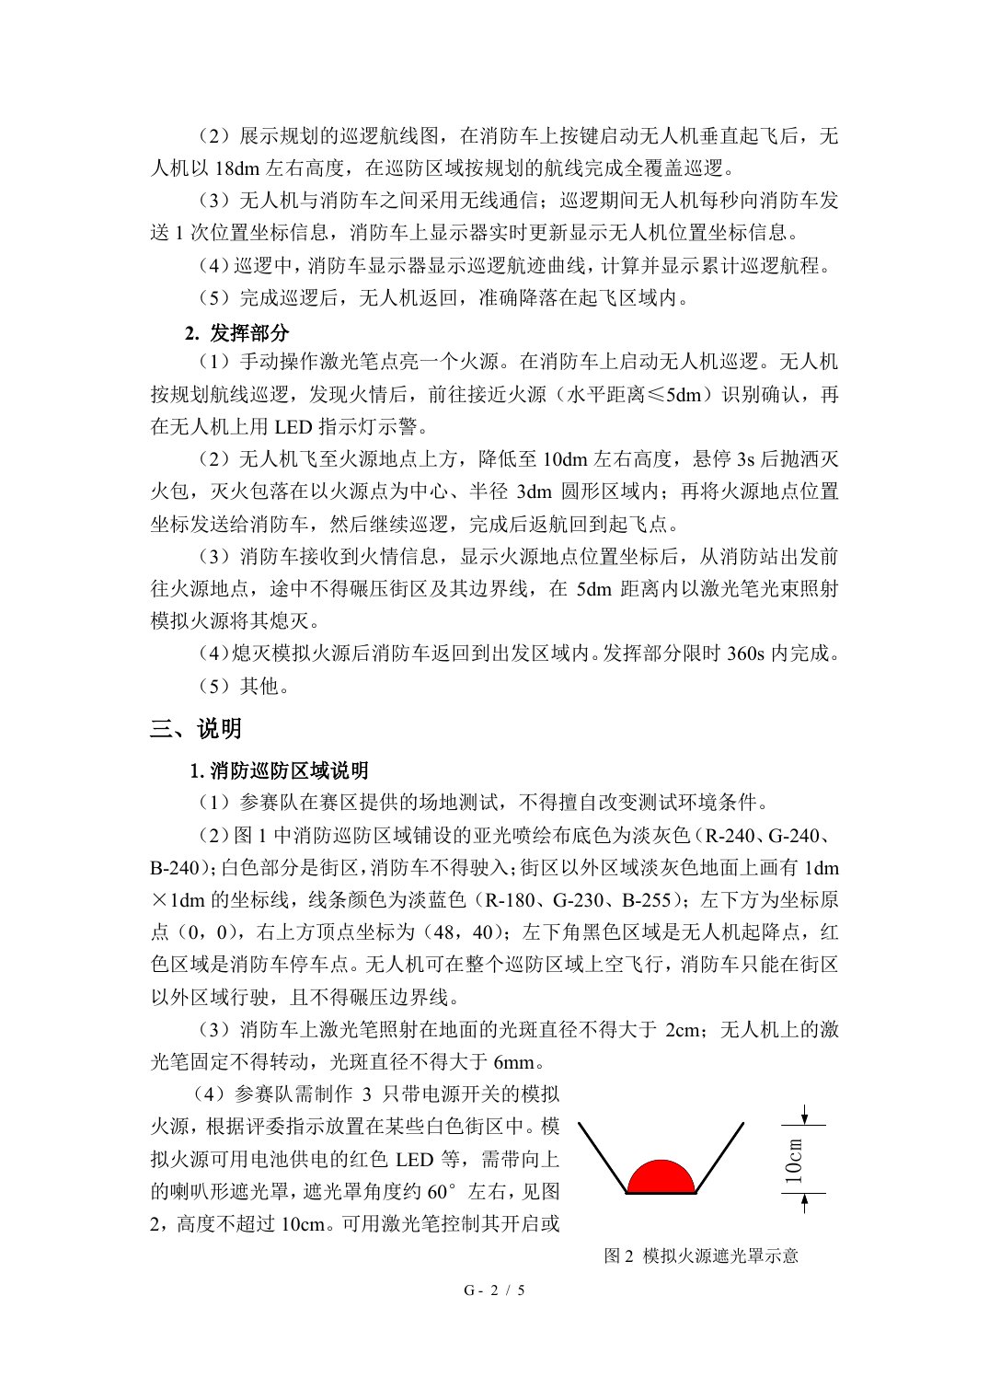
tmp/pdfs/contest_review/doc4-2.jpg
