JUYU-fsw/IT-preparation/tmp/pdfs/contest_review/doc4-3.jpg

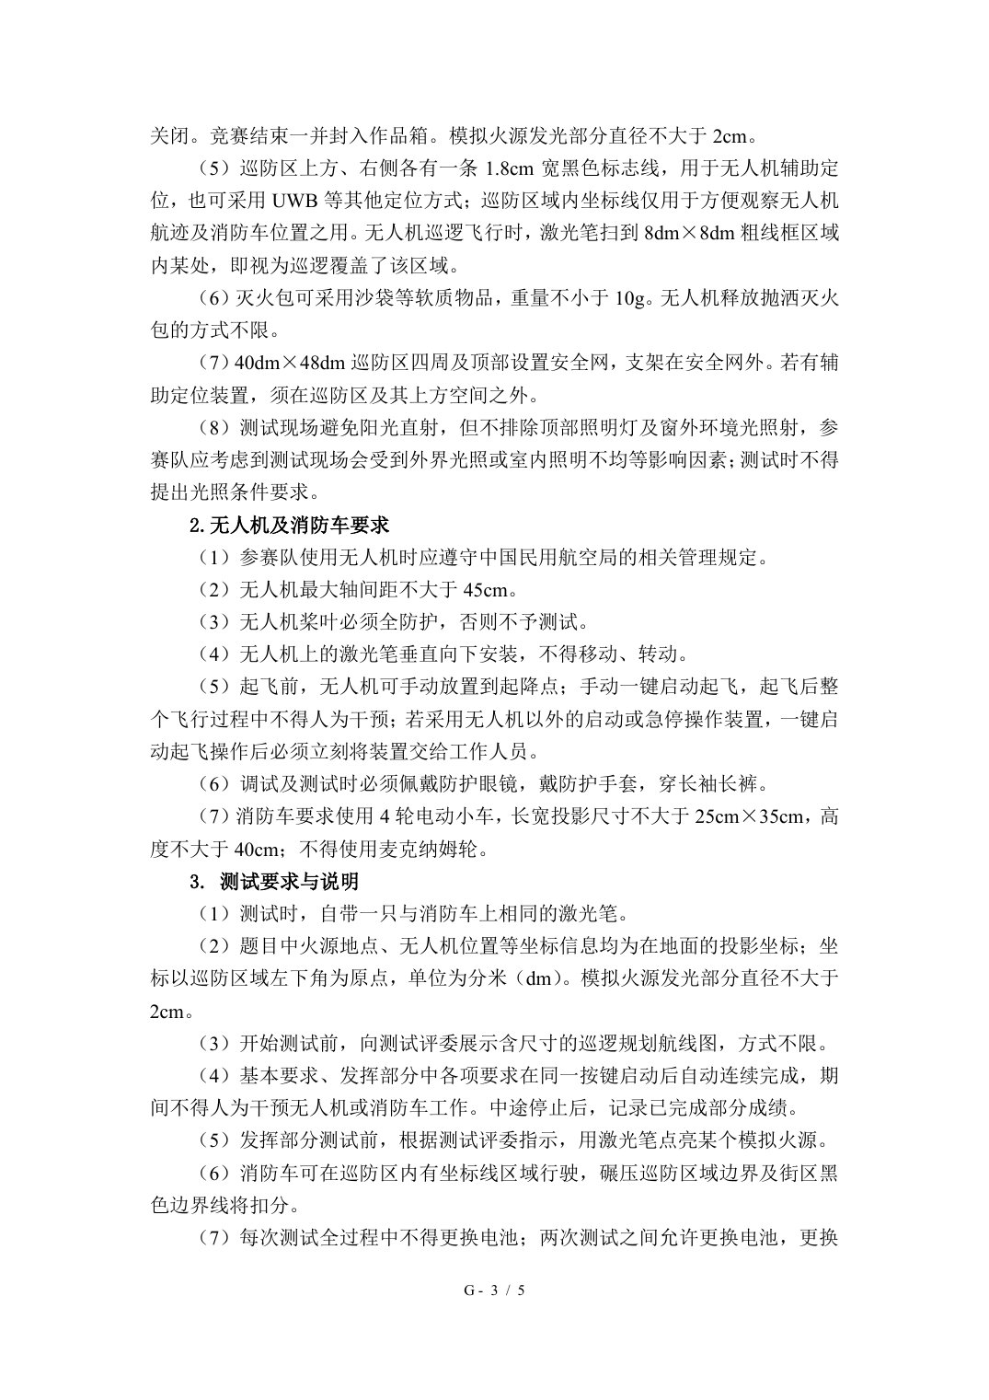
tmp/pdfs/contest_review/doc4-3.jpg
