JUYU-fsw/IT-preparation/tmp/pdfs/contest_review/doc4-4.jpg

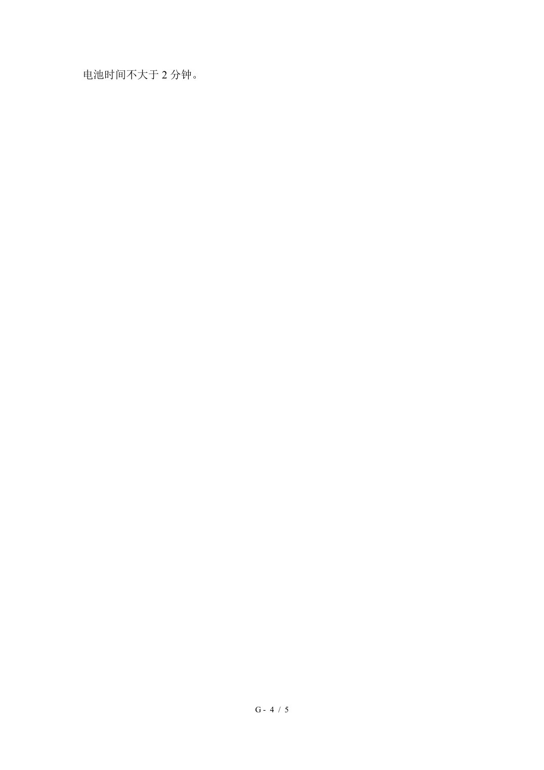
tmp/pdfs/contest_review/doc4-4.jpg
