JUYU-fsw/IT-preparation/tmp/pdfs/contest_review/doc4-5.jpg

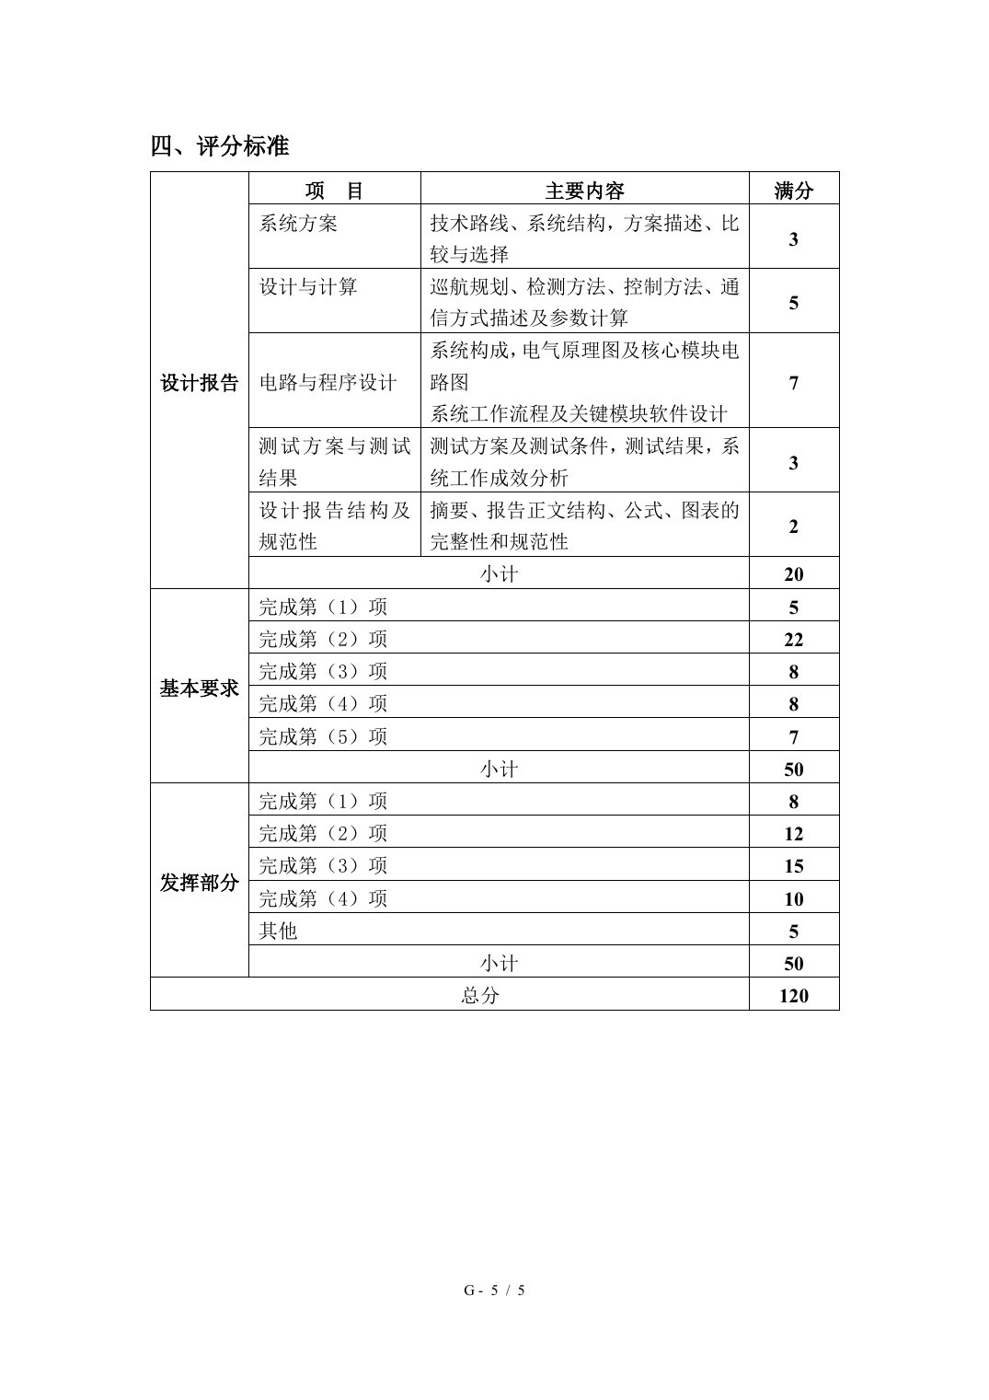
tmp/pdfs/contest_review/doc4-5.jpg
