JUYU-fsw/IT-preparation/tmp/pdfs/contest_review/doc5-1.jpg

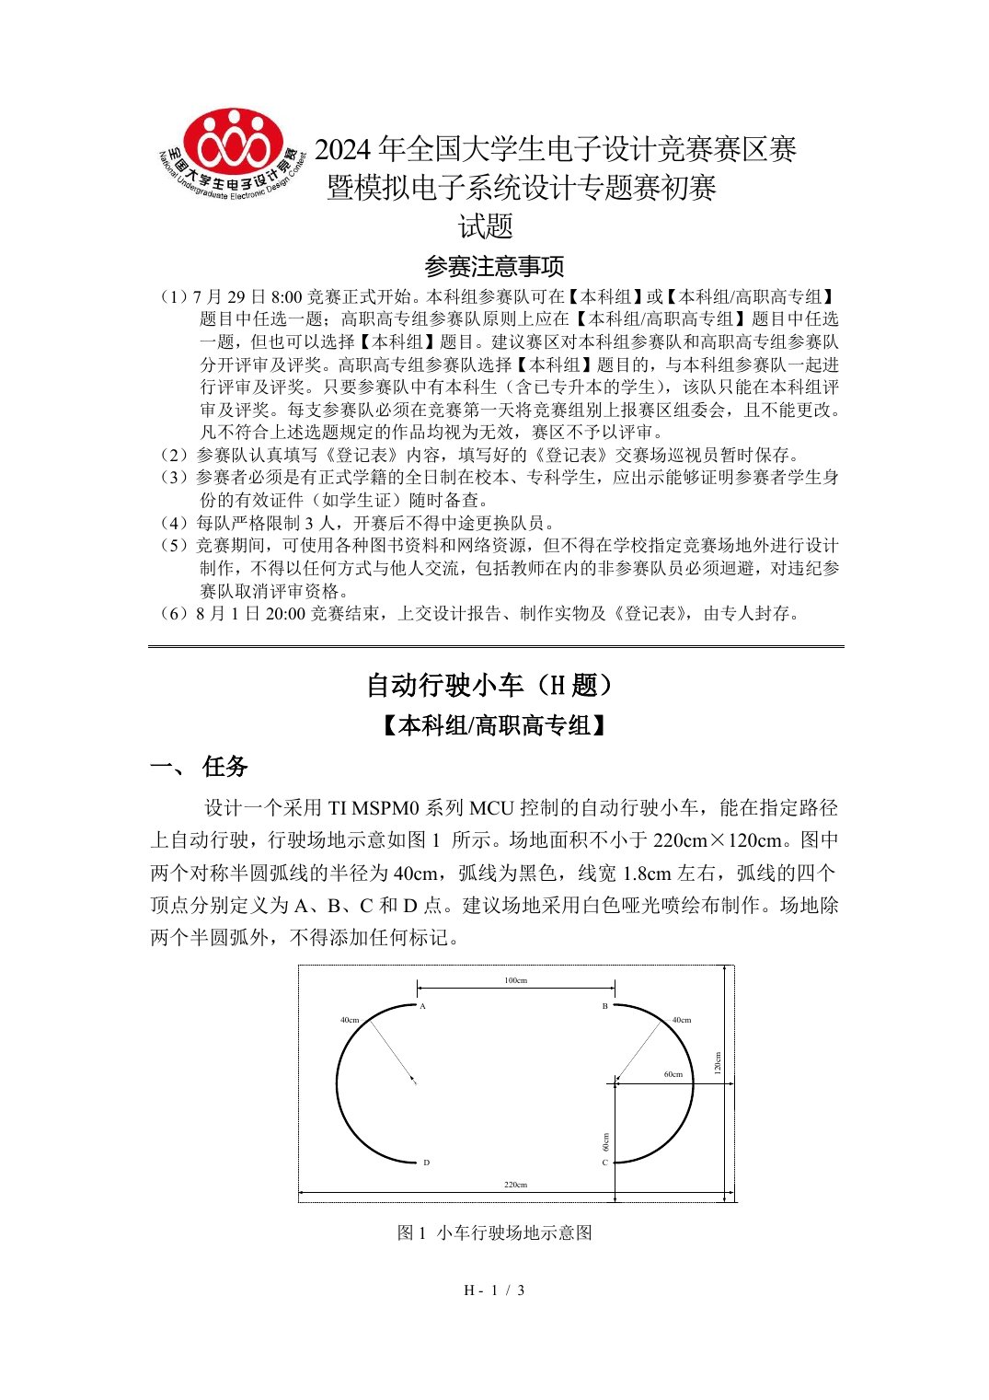
tmp/pdfs/contest_review/doc5-1.jpg
