JUYU-fsw/IT-preparation/tmp/pdfs/contest_review/doc5-2.jpg

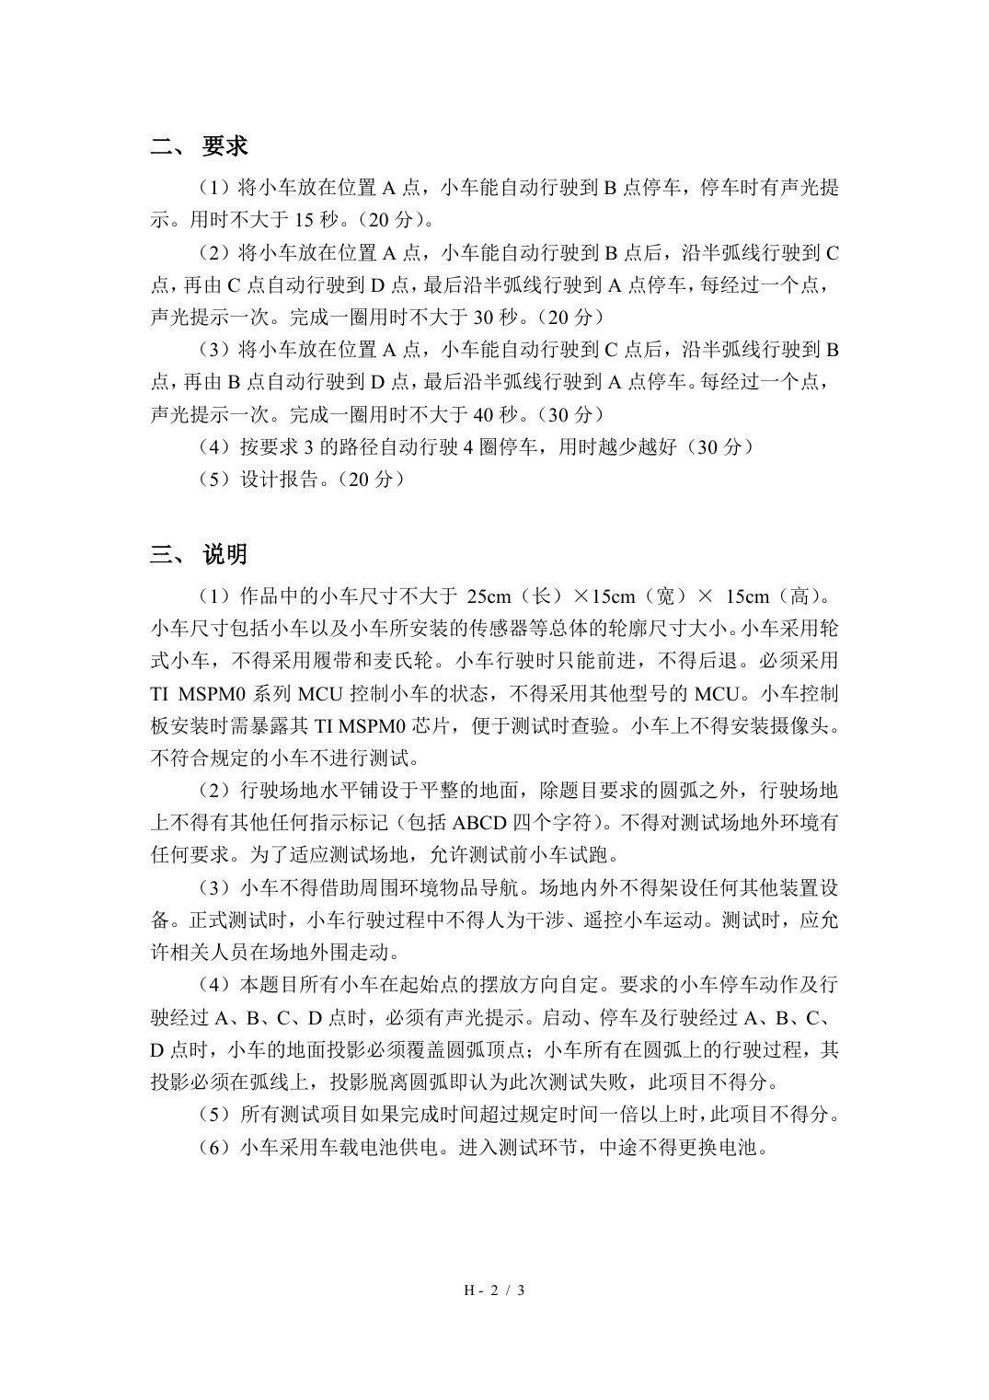
tmp/pdfs/contest_review/doc5-2.jpg
