JUYU-fsw/IT-preparation/tmp/pdfs/contest_review/doc5-3.jpg

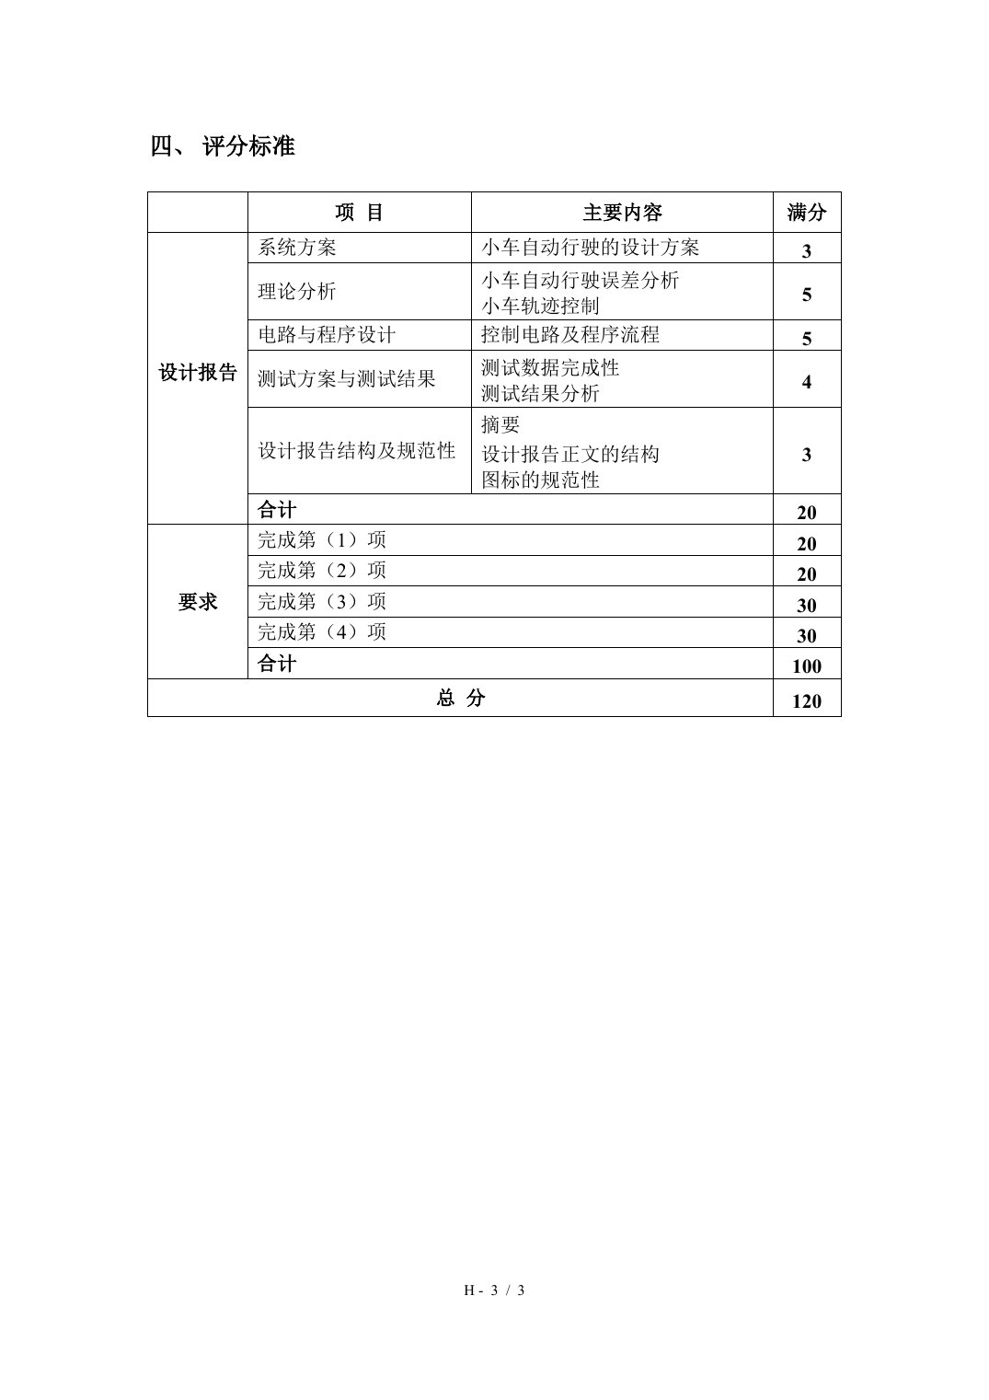
tmp/pdfs/contest_review/doc5-3.jpg
