JUYU-fsw/IT-preparation/tmp/pdfs/contest_review/doc6-1.jpg

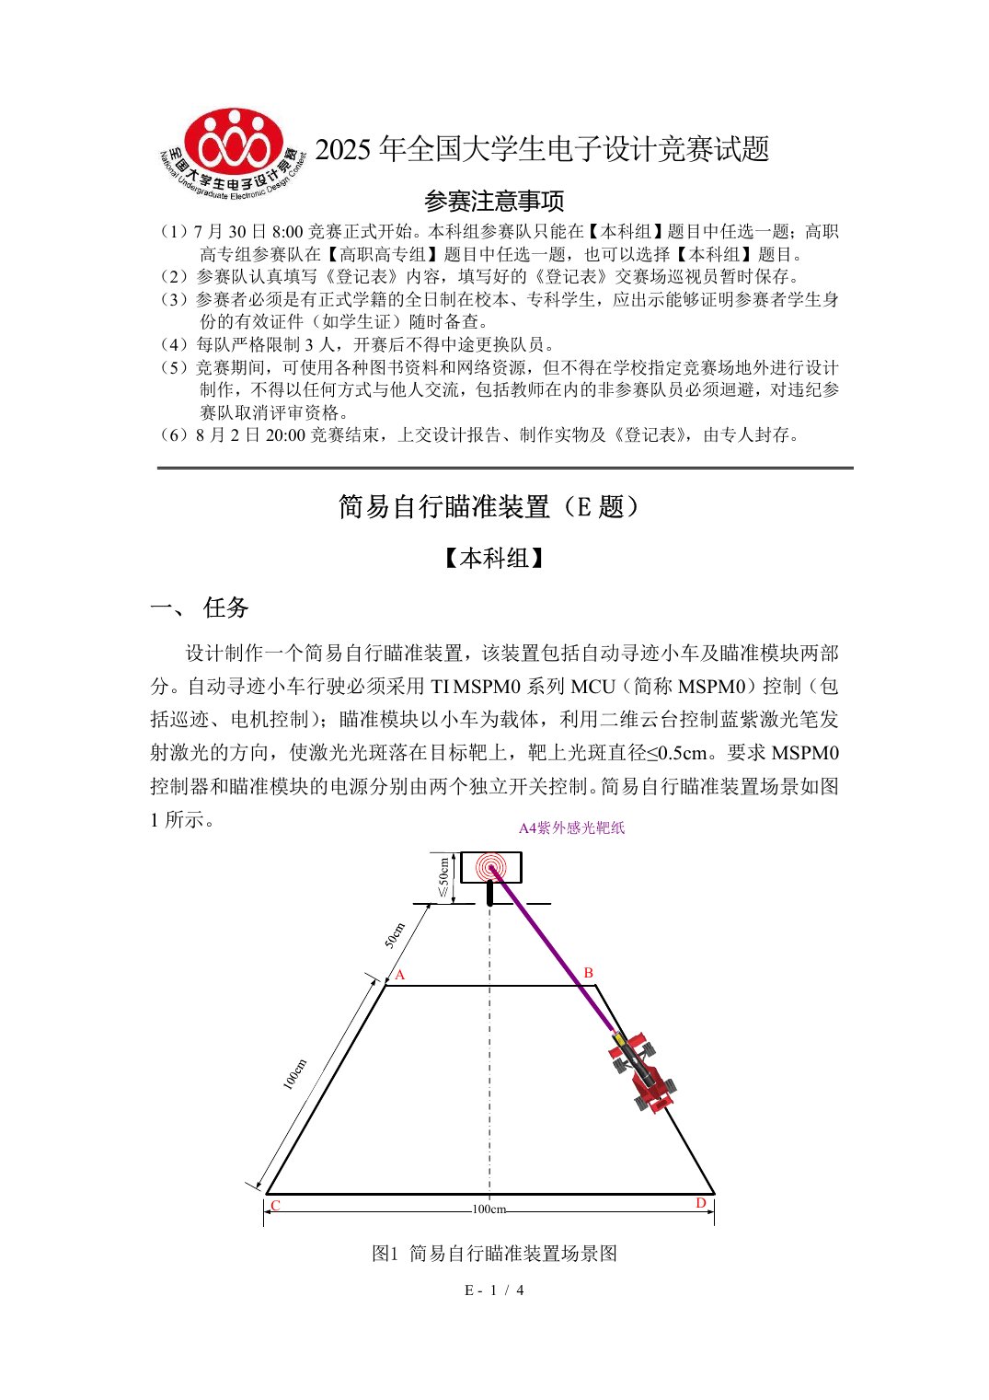
tmp/pdfs/contest_review/doc6-1.jpg
