JUYU-fsw/IT-preparation/tmp/pdfs/contest_review/doc6-2.jpg

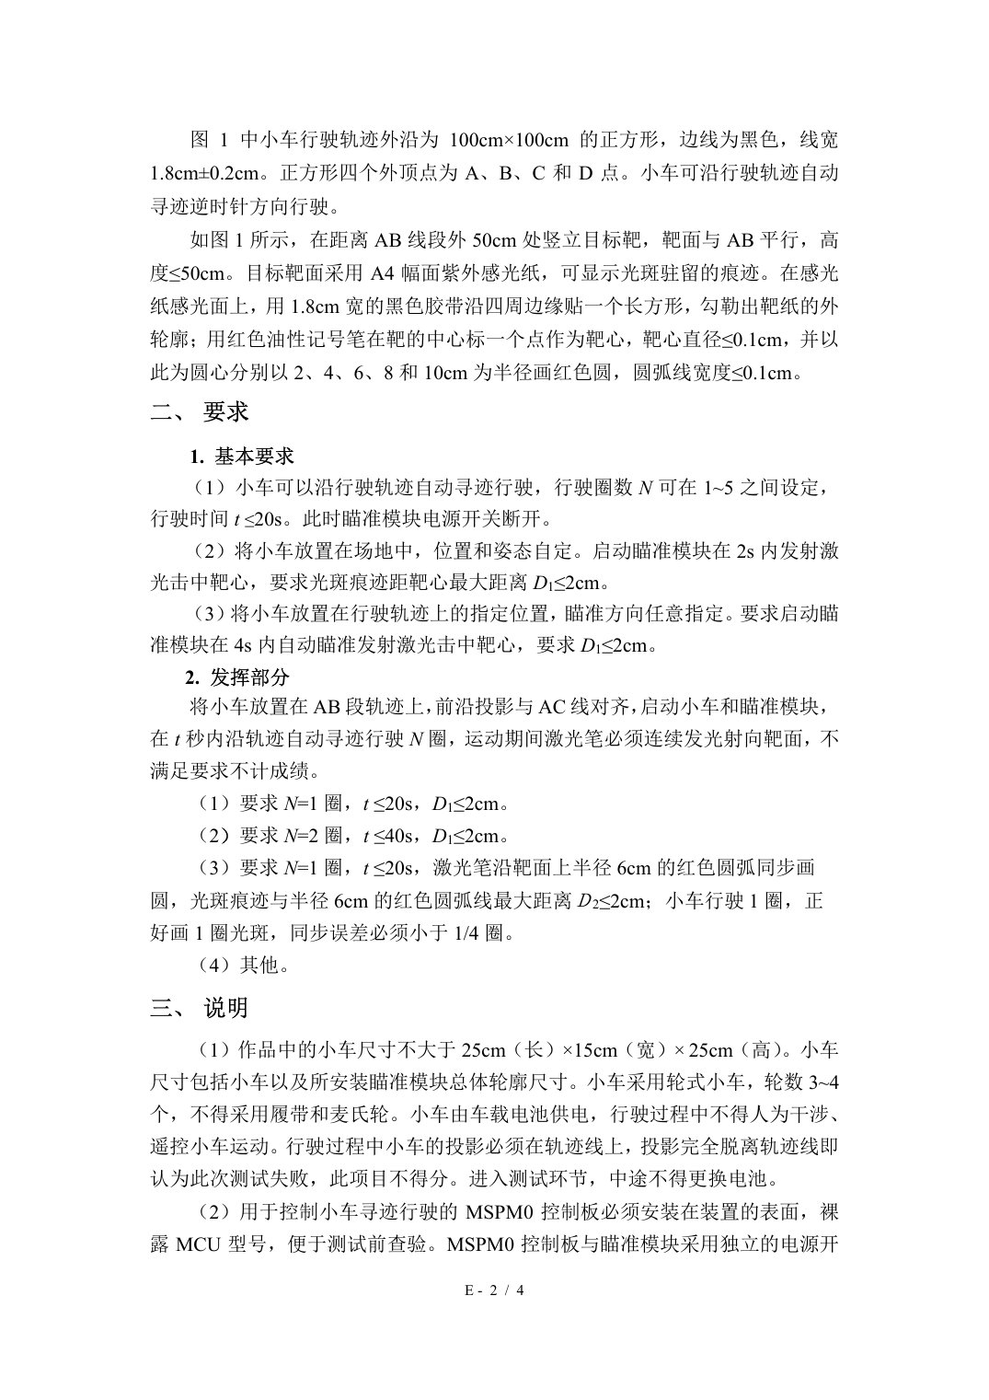
tmp/pdfs/contest_review/doc6-2.jpg
