JUYU-fsw/IT-preparation/tmp/pdfs/contest_review/doc6-3.jpg

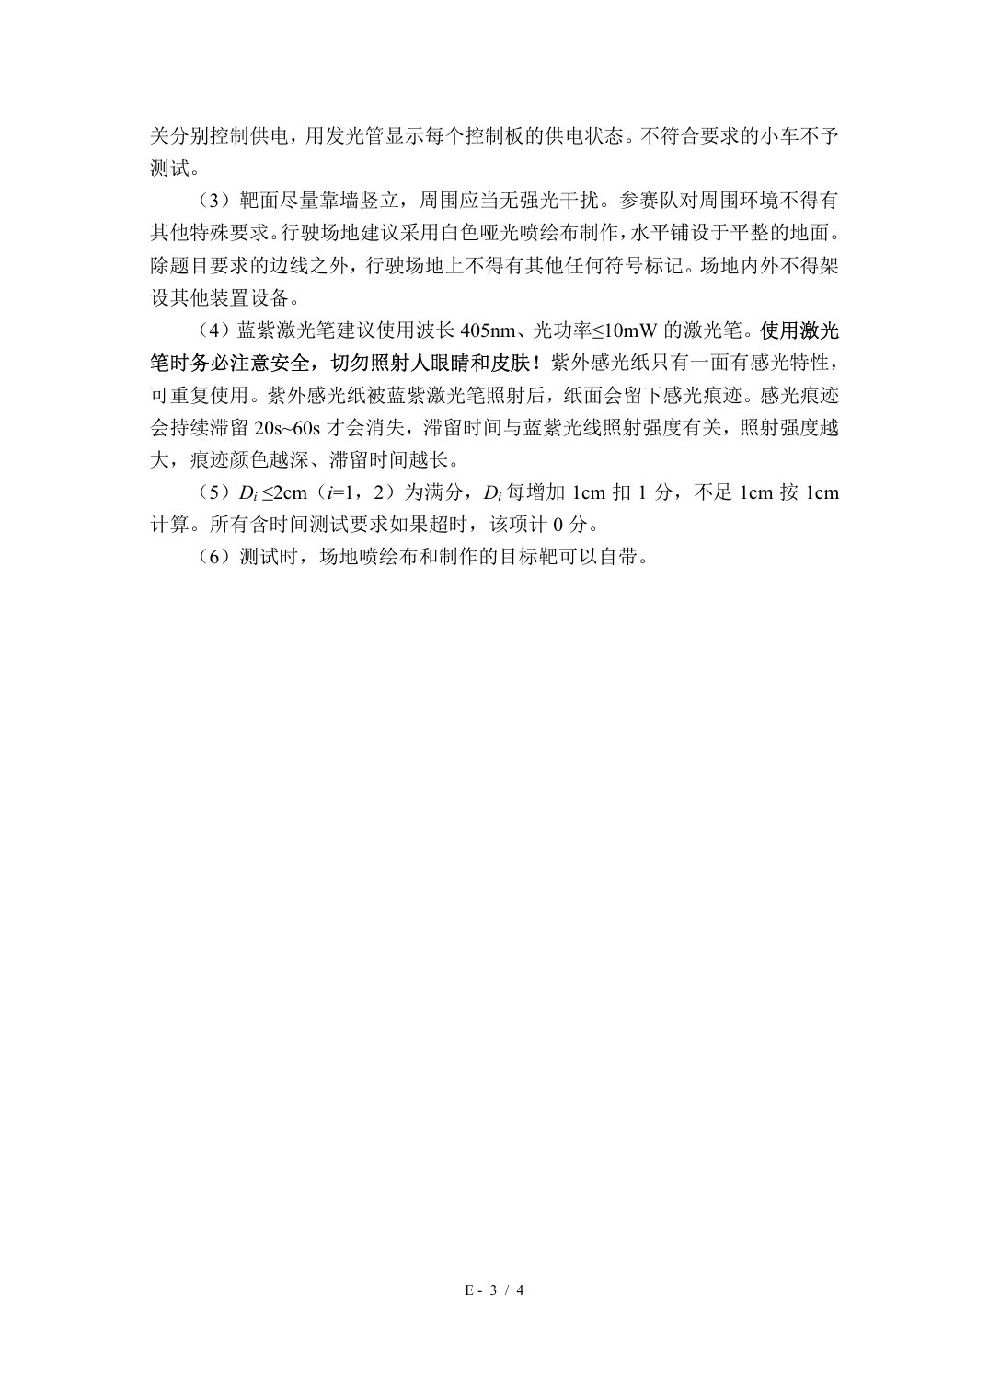
tmp/pdfs/contest_review/doc6-3.jpg
