JUYU-fsw/IT-preparation/tmp/pdfs/contest_review/doc6-4.jpg

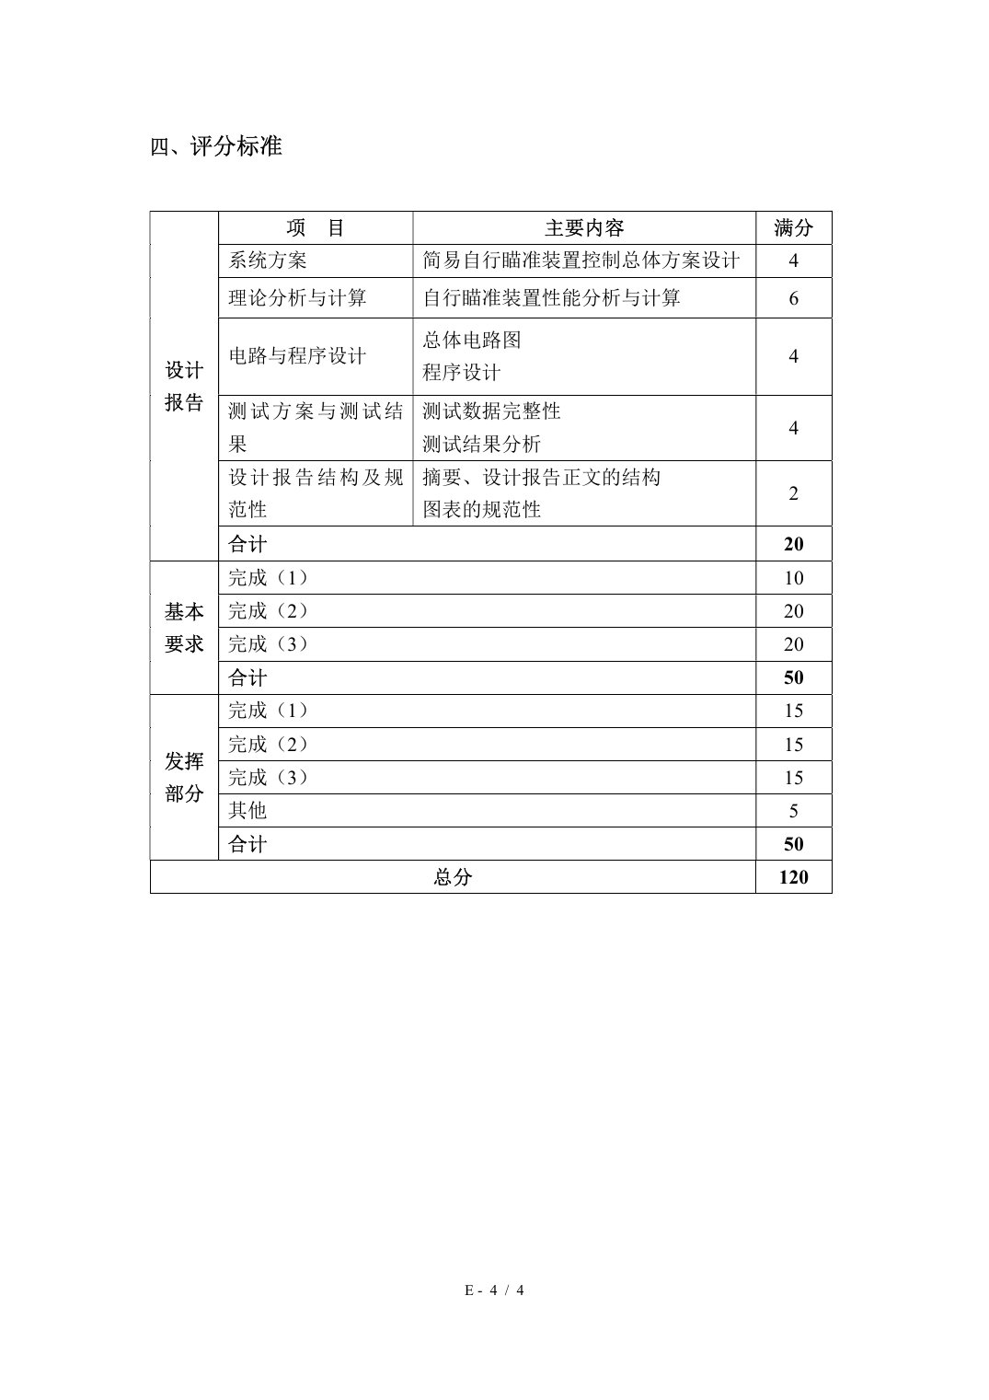
tmp/pdfs/contest_review/doc6-4.jpg
