JUYU-fsw/IT-preparation/tmp/pdfs/contest_review/doc7-1.jpg

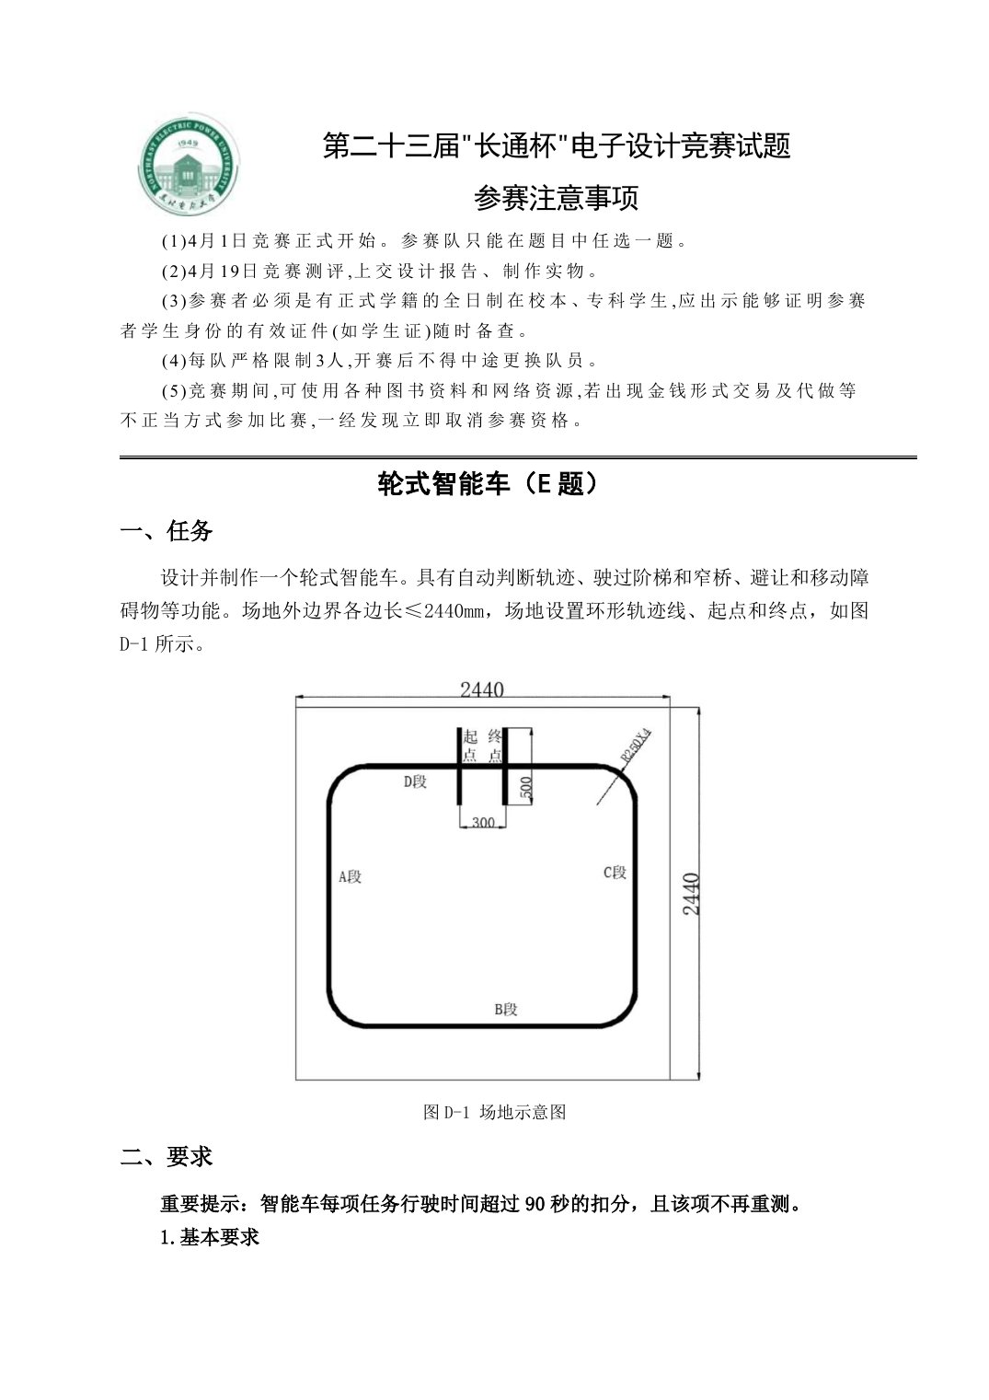
tmp/pdfs/contest_review/doc7-1.jpg
