JUYU-fsw/IT-preparation/tmp/pdfs/contest_review/doc7-2.jpg

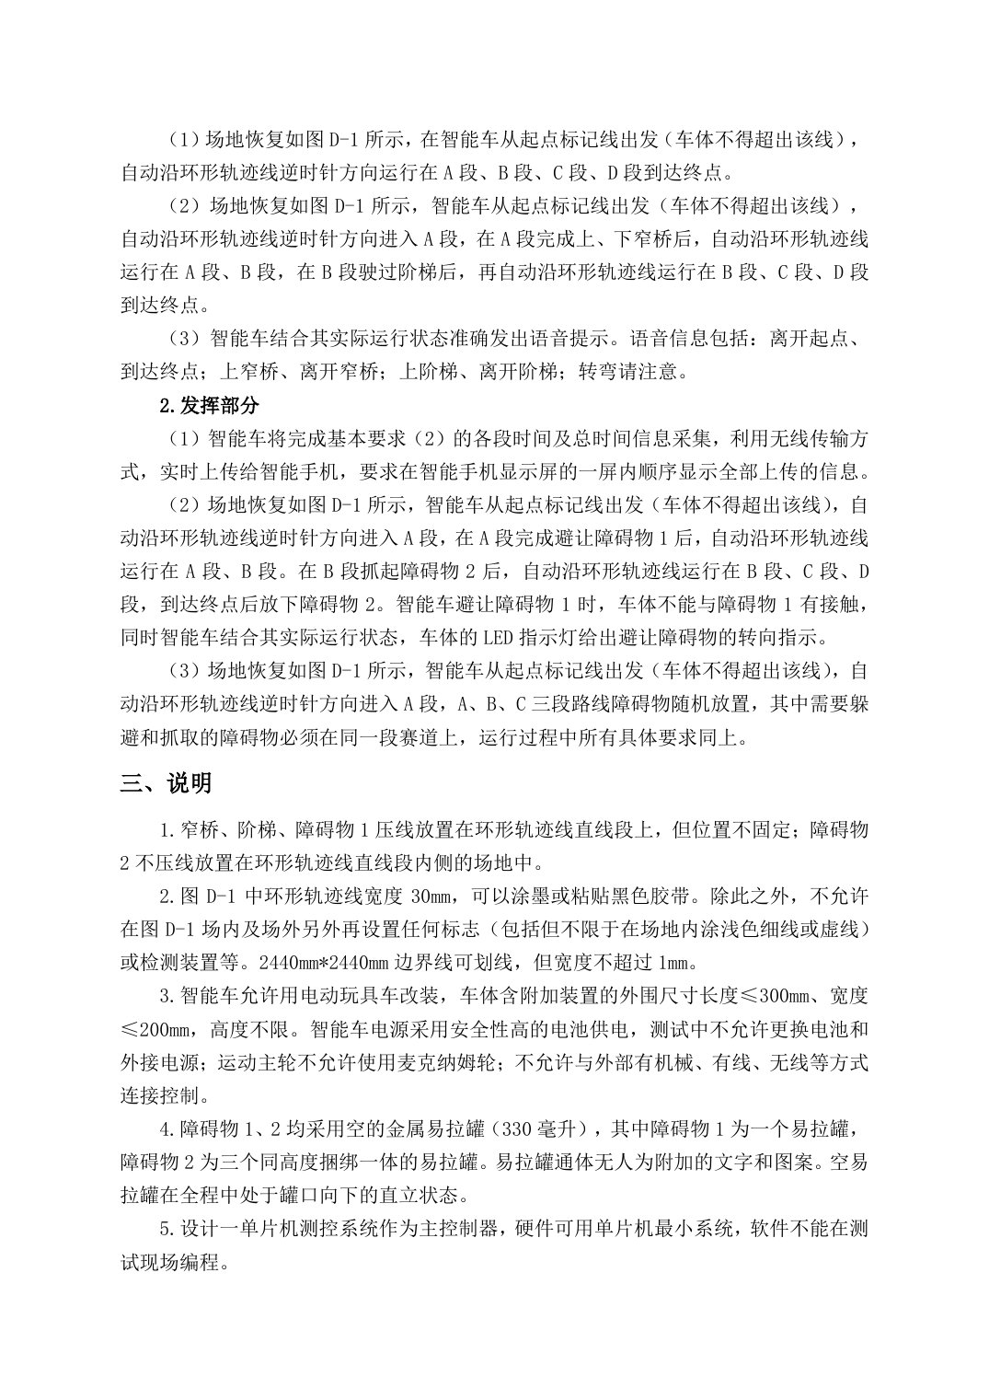
tmp/pdfs/contest_review/doc7-2.jpg
