JUYU-fsw/IT-preparation/tmp/pdfs/contest_review/doc7-3.jpg

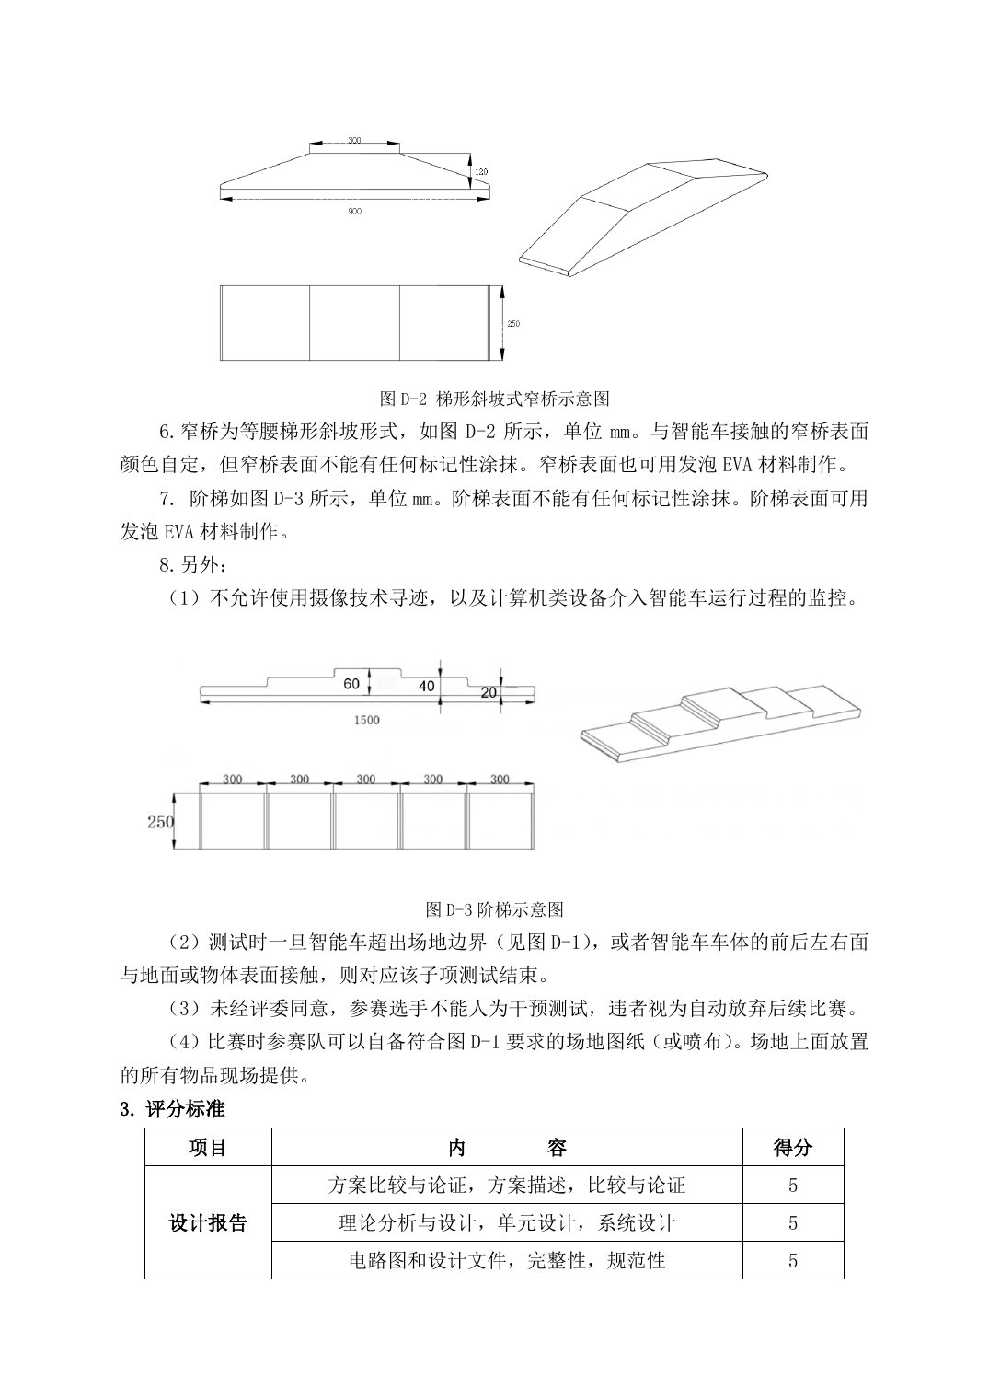
tmp/pdfs/contest_review/doc7-3.jpg
