JUYU-fsw/IT-preparation/tmp/pdfs/contest_review/doc7-4.jpg

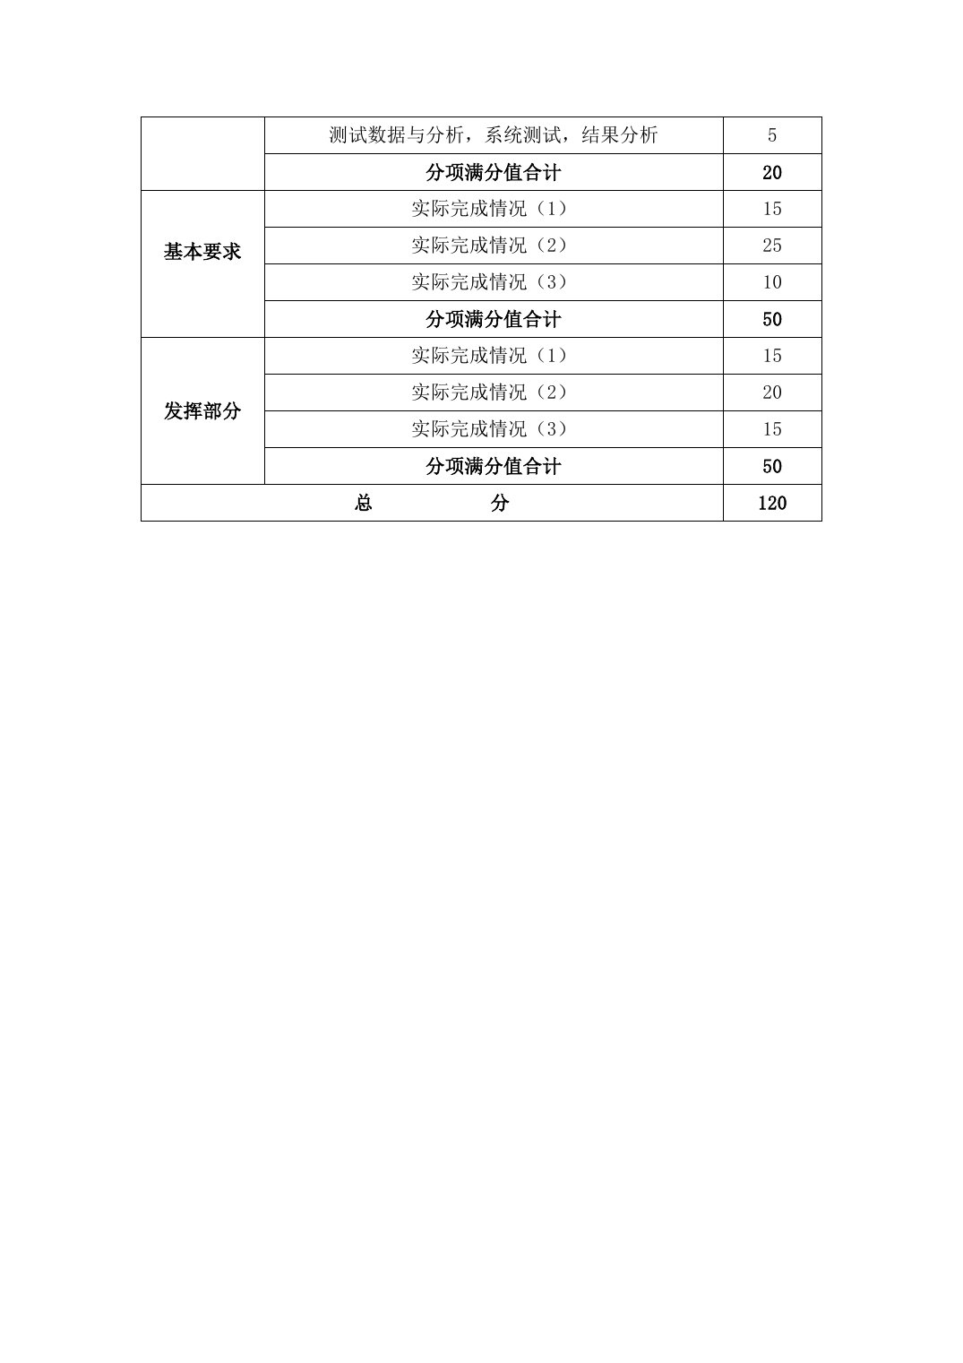
tmp/pdfs/contest_review/doc7-4.jpg
