JUYU-fsw/IT-preparation/tmp/pdfs/schematic.png

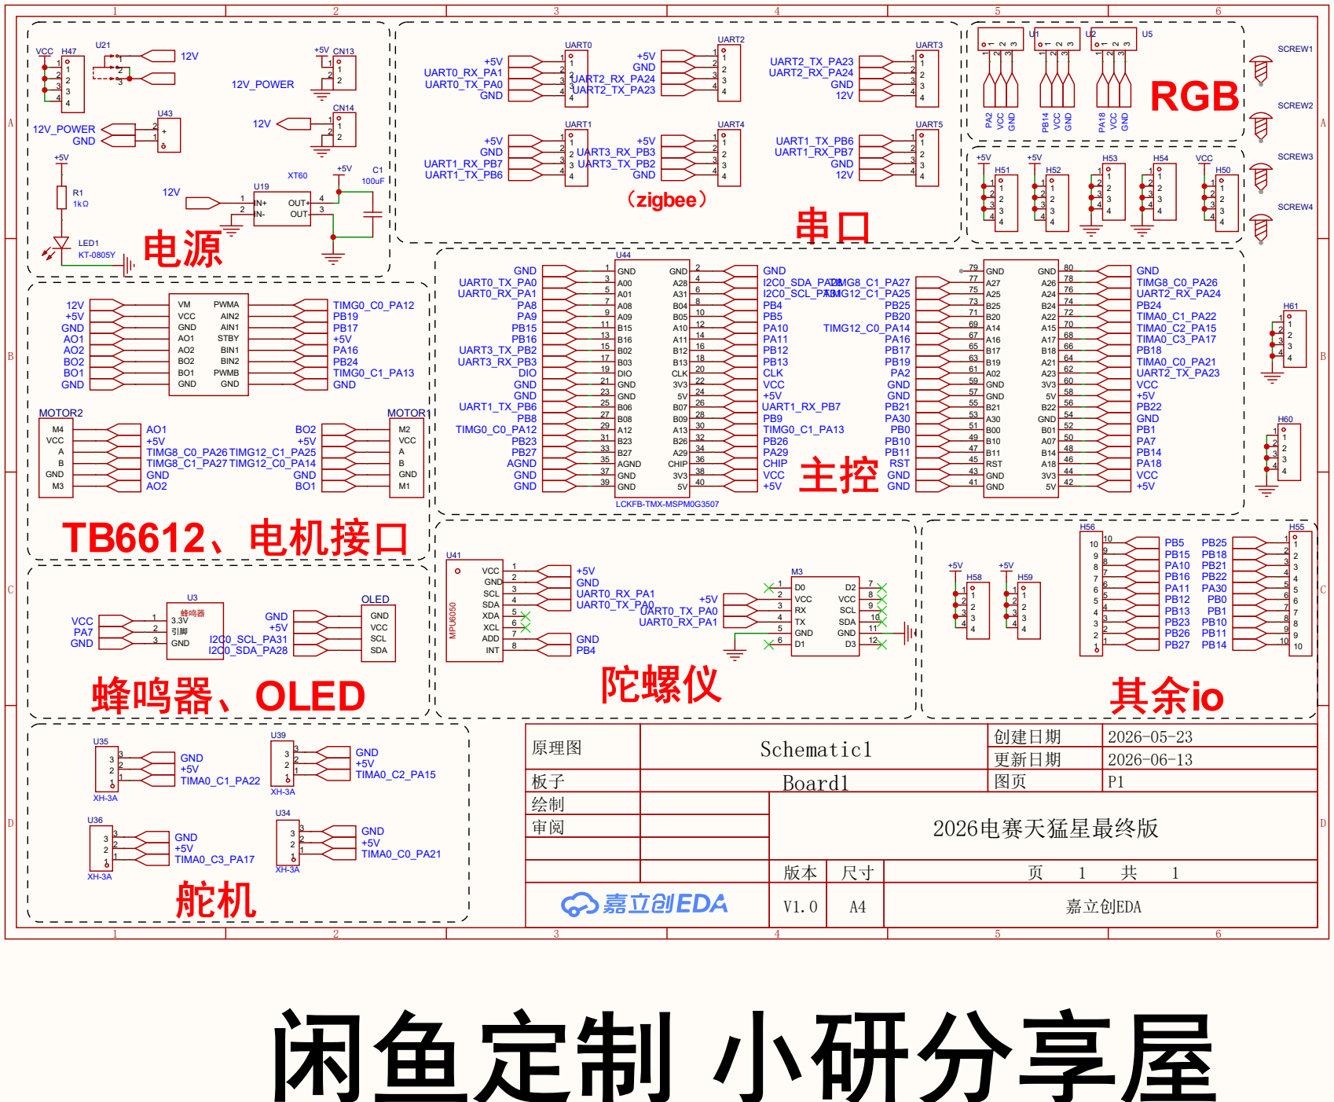
tmp/pdfs/schematic.png
