JUYU-fsw/IT-preparation/PCB/TI板卡/原理图文件/SCH_Schematic1_2026-06-13.pdf

电源

串口

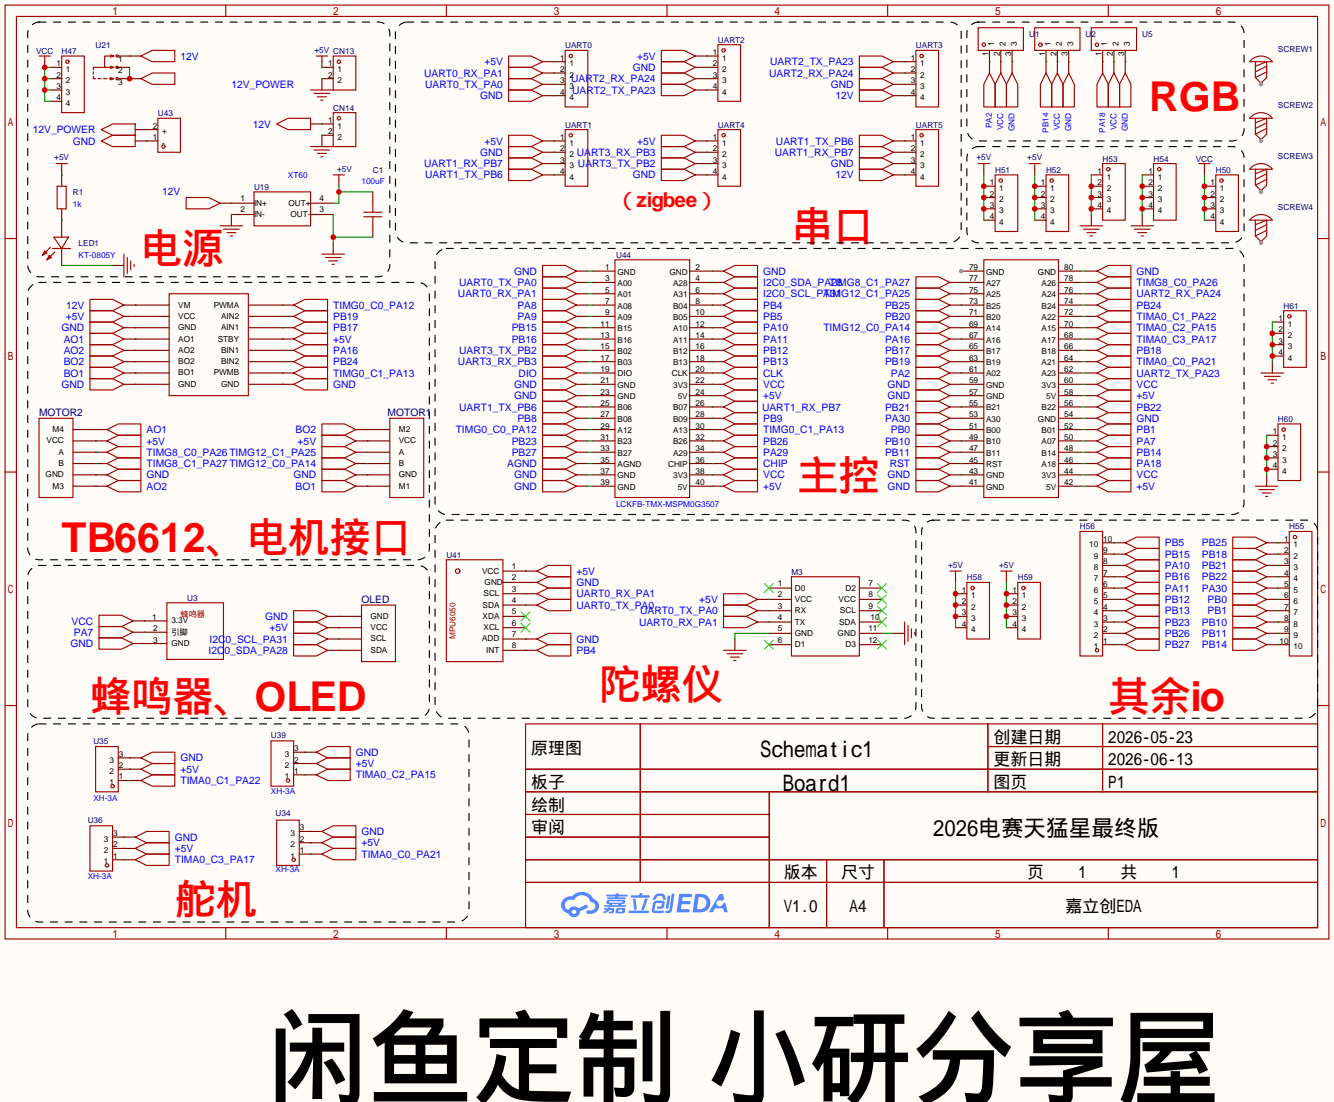
[picture p32: page 1]

原理图 | Schematic1 | 创建日期 | 2026-05-23

更新日期 | 2026-06-13

板子 | Board1 | 图页 | P1
绘制 | | 2026电赛天猛星最终版
审阅

V1.0 | A4 | 嘉立创EDA
