JUYU-fsw/IT-preparation/2024赛题复现/MSPM0G3507_Car/project/code/tb6612.h

#ifndef _tb6612_h_
#define _tb6612_h_

#include "zf_common_typedef.h"

typedef enum
{
    TB6612_MOTOR_A = 0,
    TB6612_MOTOR_B,
} tb6612_motor_enum;

// 主电源开关与供电链路已完成，允许外层工程进行架空 PID 测试。
#define TB6612_OUTPUT_ENABLE    (1)

#define TB6612_DUTY_MAX         (10000)
#define TB6612_PWM_FREQUENCY    (20000)

void tb6612_init       (void);
void tb6612_set_motor  (tb6612_motor_enum motor, int16 duty);
void tb6612_stop_motor (tb6612_motor_enum motor);
void tb6612_stop_all   (void);

#endif
