JUYU-fsw/IT-preparation/(commit log)

2026-07-23 @ Initial commit: TI preparation project
    - TI PCB board design files (Gerber + schematic)
    - MSPM0G3507 Car embedded project with SDK libraries
    - Project documentation and configuration files
    @
    [Drill_PTH_Through.DRL, Drill_PTH_Through_Via.DRL, Gerber_BoardOutlineLayer.GKO, Gerber_BottomLayer.GBL, Gerber_BottomPasteMaskLayer.GBP, Gerber_BottomSilkscreenLayer.GBO, Gerber_BottomSolderMaskLayer.GBS, Gerber_TopLayer.GTL]
2026-07-24 7.24调RM的PID
2026-07-26 7.25更新巡线，小车搭建完成
2026-07-26 更新巡线项目文档
2026-07-26 7.26角度环代码
2026-07-26 更新赛题针对分析
2026-07-26 忘记写日志了
2026-07-26 2024赛题
2026-07-27 stabilize MPU drift and avoid blocking Bluetooth during control
    [main.c]
2026-07-27 document restored line sensor wiring and remaining faults
2026-07-27 角度环完善
